VittorioCoseglia/JBR/gabinete/Gabinete.SLDASM

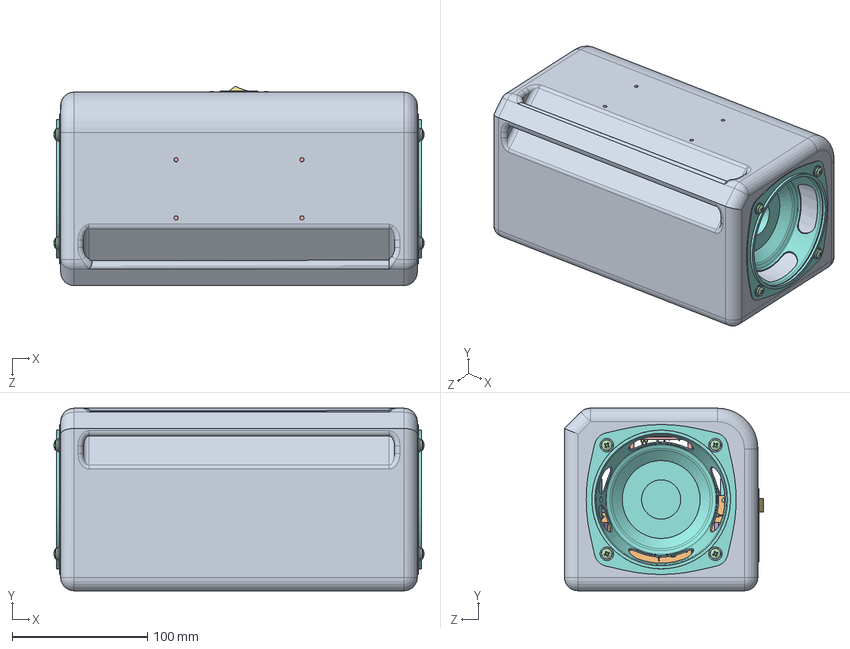
[picture p19: CAD file, 2026-11-05]
gabinete/Gabinete.SLDASM
273.4 x 135.0 x 147.2 mm
Pieza1
Trafo9V.stp
CP_Radial_D22.0mm_P10.00mm_SnapIn.step x 4
TerminalBlock_Phoenix_MKDS-1,5-3_1x03_P5.00mm_Horizontal.step x 6
Diode_Bridge_Vishay_GBU.step
Fuente x4_PCB.step
HeatSink.step x 4
M2x6-Screw.step x 4
R_Axial_DIN0207_L6.3mm_D2.5mm_P10.16mm_Horizontal.step x 18
R_Axial_DIN0309_L9.0mm_D3.2mm_P15.24mm_Horizontal.step x 2
C_Radial_D6.3mm_H11.0mm_P2.50mm.step x 2
Potentiometer_Bourns_3296W_Vertical.step x 4
D_DO-35_SOD27_P7.62mm_Horizontal.step x 12
TerminalBlock_Phoenix_MKDS-1,5-2_1x02_P5.00mm_Horizontal.step x 4
TO-126-3_Vertical.step x 4
wakefield-vette heatsink 281-3AB.step x 4
C_Disc_D5.0mm_W2.5mm_P2.50mm.step x 8
R_Axial_Power_L25.0mm_W6.4mm_P30.48mm.step x 4
D_DO-41_SOD81_P10.16mm_Horizontal.step x 4
TO-220-3_Vertical.step x 4
DIP-8_W7.62mm.step x 2
DIP-8_W7.62mm_Socket.step x 2
TO-92_Inline.step x 2
C_Radial_D10.0mm_H20.0mm_P5.00mm.step x 4
C_Disc_D3.0mm_W2.0mm_P2.50mm.step x 2
AB_PCB.step x 2
fuse_holder
fuse
Plate x 3
Button
Speaker 30W 4-Ohm 4-inch.step x 2
plain washer 10669 type nl_iso x 22
countersunk raised head cross recess screw_iso x 2
hex thin nut chamfered gradeab_iso x 40
pan head cross recess screw_iso x 14
Varilla x 4
PinHeader_1x01_P2.00mm_Horizontal.step.STEP x 3
PinHeader_1x01_P2.00mm_Vertical.step.STEP x 2
TO-220-3_Horizontal_TabDown.step.STEP
LED_D5.0mm.step.STEP
C_Radial_D5.0mm_H11.0mm_P2.00mm.step.STEP x 2
R_Axial_DIN0207_L6.3mm_D2.5mm_P10.16mm_Horizontal.step.STEP
TerminalBlock_Phoenix_MKDS-1,5-2_1x02_P5.00mm_Horizontal.step.STEP x 3
Control_PCB.step.STEP
001^PJ311D_WOPos.step.STEP
002^PJ311D_WOPos.step.STEP
003^PJ311D_WOPos.step.STEP
004^PJ311D_WOPos.step.STEP
005^PJ311D_WOPos.step.STEP
006^PJ311D_WOPos.step.STEP
007^PJ311D_WOPos.step.STEP
Crystal 24MHz v1.step.STEP
SMD_CAP.step.STEP x 7
RESISTOR_SMD.step.STEP x 3
CAPAE-D6.3x5.4.step.STEP x 2
SW3dPS-SOIC24 v1.step.STEP
RESISTOR_SMD v2.step.STEP
REAL-Usb 5pin Board.step.STEP
LITE-ON - LTST-C190KFKT.step.STEP
BT Board VHM-314.step-0.STEP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
