VittorioCoseglia/JBR/gabinete/Accesorios/CRH.SLDASM

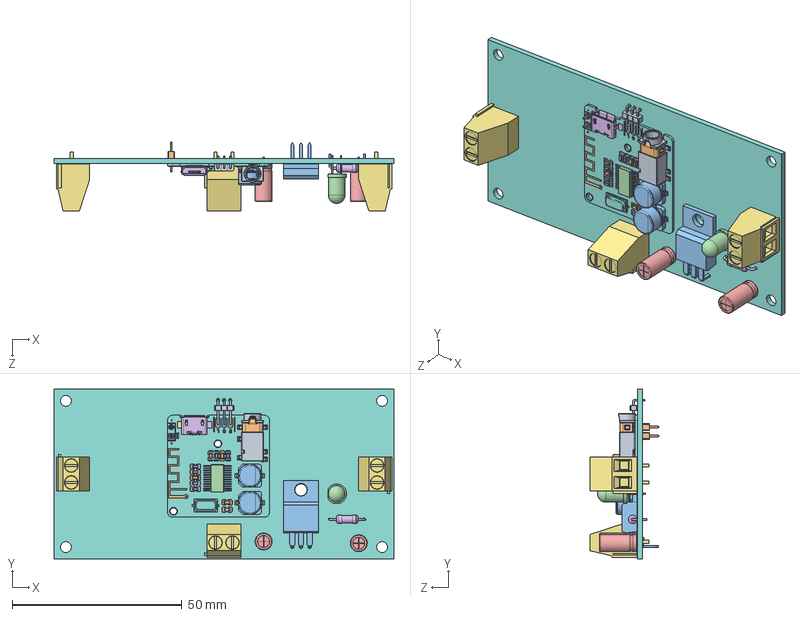
[picture p20: CAD file, 2026-11-05]
gabinete/Accesorios/CRH.SLDASM
100.0 x 50.0 x 20.2 mm
PinHeader_1x01_P2.00mm_Horizontal.step x 3
PinHeader_1x01_P2.00mm_Vertical.step x 2
TO-220-3_Horizontal_TabDown.step
LED_D5.0mm.step
C_Radial_D5.0mm_H11.0mm_P2.00mm.step x 2
R_Axial_DIN0207_L6.3mm_D2.5mm_P10.16mm_Horizontal.step
TerminalBlock_Phoenix_MKDS-1,5-2_1x02_P5.00mm_Horizontal.step x 3
Control_PCB.step
001^PJ311D_WOPos.step
002^PJ311D_WOPos.step
003^PJ311D_WOPos.step
004^PJ311D_WOPos.step
005^PJ311D_WOPos.step
006^PJ311D_WOPos.step
007^PJ311D_WOPos.step
Crystal 24MHz v1.step
SMD_CAP.step x 7
RESISTOR_SMD.step x 3
CAPAE-D6.3x5.4.step x 2
SW3dPS-SOIC24 v1.step
RESISTOR_SMD v2.step
REAL-Usb 5pin Board.step
LITE-ON - LTST-C190KFKT.step
BT Board VHM-314.step
BT Board VHM-314-0.step
BT Board VHM-314-1.step
BT Board VHM-314-2.step
BT Board VHM-314-3.step
BT Board VHM-314-4.step
BT Board VHM-314-5.step
BT Board VHM-314-6.step
BT Board VHM-314-7.step
BT Board VHM-314-8.step
BT Board VHM-314-9.step
BT Board VHM-314-10.step
BT Board VHM-314-11.step
BT Board VHM-314-12.step
BT Board VHM-314-13.step
BT Board VHM-314-14.step
BT Board VHM-314-15.step
BT Board VHM-314-16.step
BT Board VHM-314-17.step
BT Board VHM-314-18.step
BT Board VHM-314-19.step
BT Board VHM-314-20.step
BT Board VHM-314-21.step
BT Board VHM-314-22.step
BT Board VHM-314-23.step
BT Board VHM-314-24.step
BT Board VHM-314-25.step
BT Board VHM-314-26.step
BT Board VHM-314-27.step
BT Board VHM-314-28.step
BT Board VHM-314-29.step
BT Board VHM-314-30.step
BT Board VHM-314-31.step
BT Board VHM-314-32.step
BT Board VHM-314-33.step
BT Board VHM-314-34.step
BT Board VHM-314-35.step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
