VittorioCoseglia/JBR/gabinete/Impresion 3D/Solidworks/conjunto.SLDASM

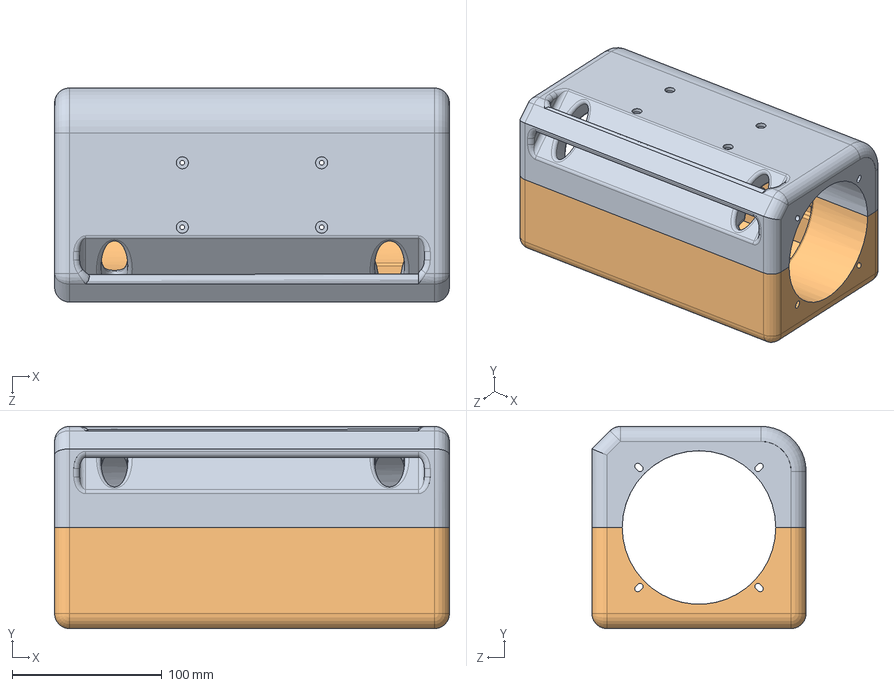
[picture p21: CAD file, 2026-11-05]
gabinete/Impresion 3D/Solidworks/conjunto.SLDASM
263.7 x 135.0 x 143.0 mm
abajo
arriba
