VittorioCoseglia/JBR/gabinete/Accesorios/AC_01A_Assem/AC_01A_Assem.SLDASM

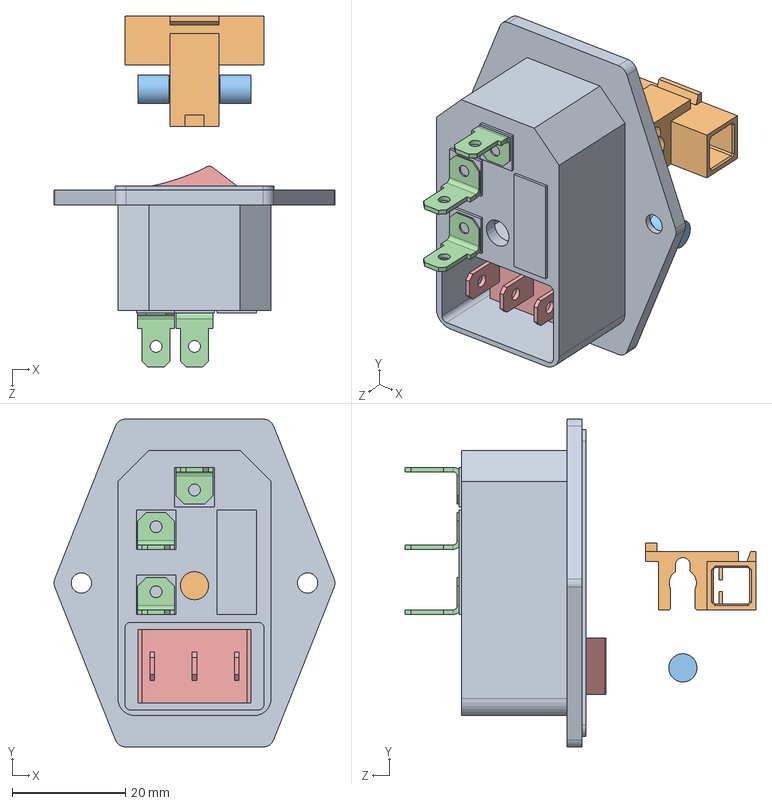
[picture p22: CAD file, 2026-11-05]
gabinete/Accesorios/AC_01A_Assem/AC_01A_Assem.SLDASM
49.7 x 58.0 x 62.0 mm
fuse_holder
fuse
Plate x 3
Button
