VittorioCoseglia/JBR/AB/3D/HeatsinkTO220.step

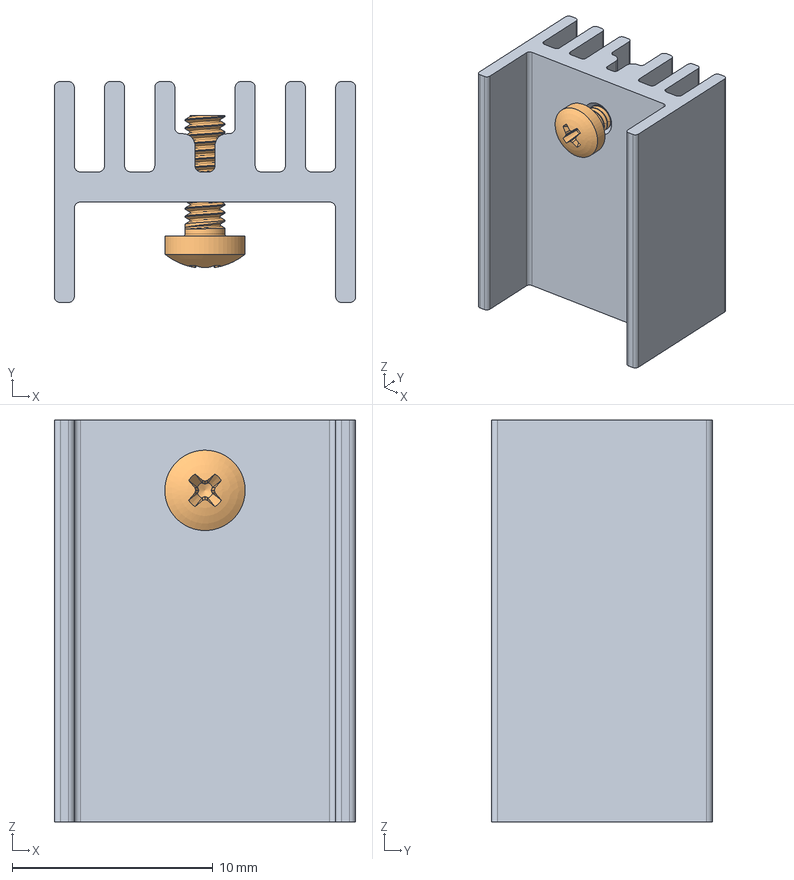
[picture p23: CAD file, 2026-11-05]
AB/3D/HeatsinkTO220.step
15.0 x 11.0 x 20.0 mm
HeatSink
M2x6-Screw
