VittorioCoseglia/JBR/gabinete/Accesorios/AC_01A_Assem/Plate.SLDPRT

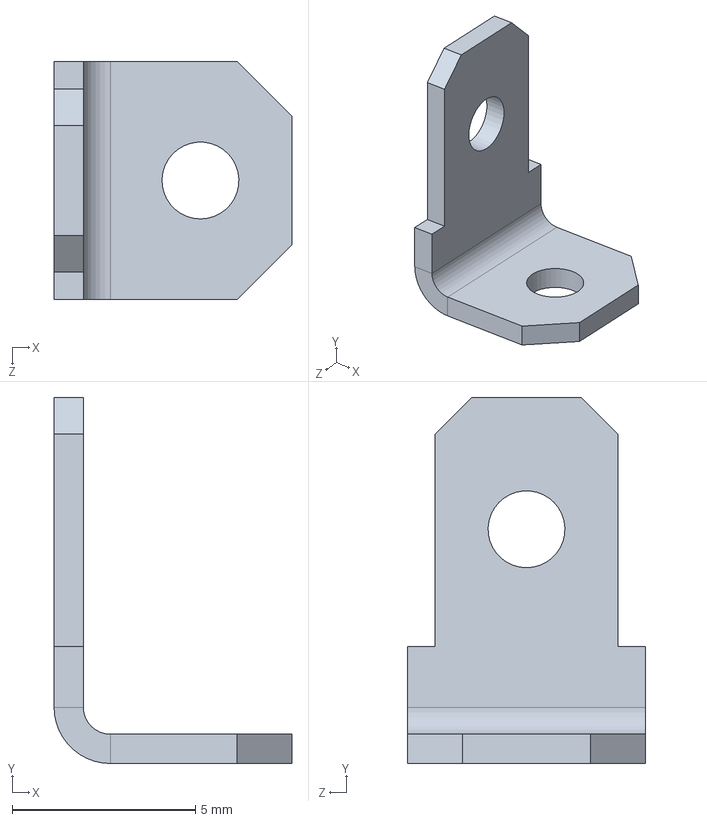
[picture p24: CAD file, 2026-11-05]
gabinete/Accesorios/AC_01A_Assem/Plate.SLDPRT
6.50 x 10.0 x 6.50 mm
