VittorioCoseglia/JBR/gabinete/Accesorios/Trafo9V.stp

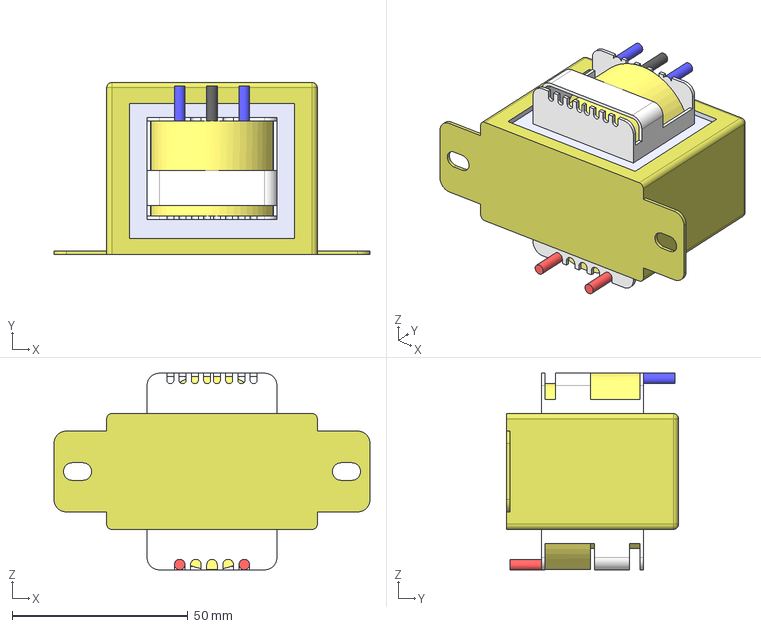
[picture p25: CAD file, 2026-11-05]
gabinete/Accesorios/Trafo9V.stp
90.0 x 49.0 x 56.0 mm
