VittorioCoseglia/JBR/gabinete/Impresion 3D/Solidworks/abajo.SLDPRT

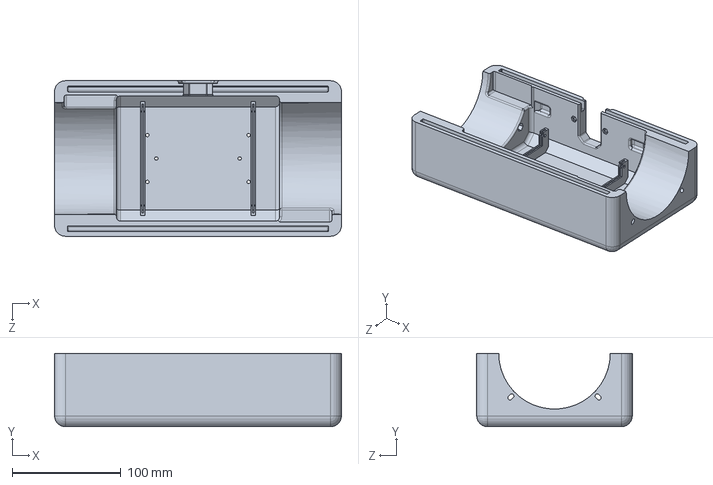
[picture p26: CAD file, 2026-11-05]
gabinete/Impresion 3D/Solidworks/abajo.SLDPRT
263.7 x 67.5 x 143.0 mm
