VittorioCoseglia/JBR/gabinete/PCBs/CTR/CRH.step

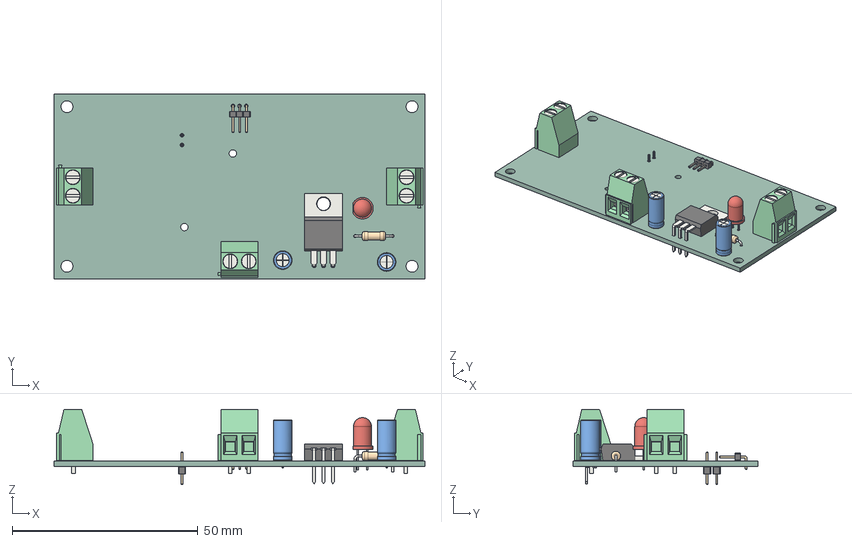
[picture p27: CAD file, 2026-11-05]
gabinete/PCBs/CTR/CRH.step
100.0 x 50.0 x 20.2 mm
PinHeader_1x01_P2.00mm_Horizontal x 3
PinHeader_1x01_P2.00mm_Vertical x 2
TO-220-3_Horizontal_TabDown
LED_D5.0mm
C_Radial_D5.0mm_H11.0mm_P2.00mm x 2
R_Axial_DIN0207_L6.3mm_D2.5mm_P10.16mm_Horizontal
TerminalBlock_Phoenix_MKDS-1,5-2_1x02_P5.00mm_Horizontal x 3
Control_PCB
