VittorioCoseglia/JBR/AB/3D/wakefield-vette heatsink 281-3AB.stp

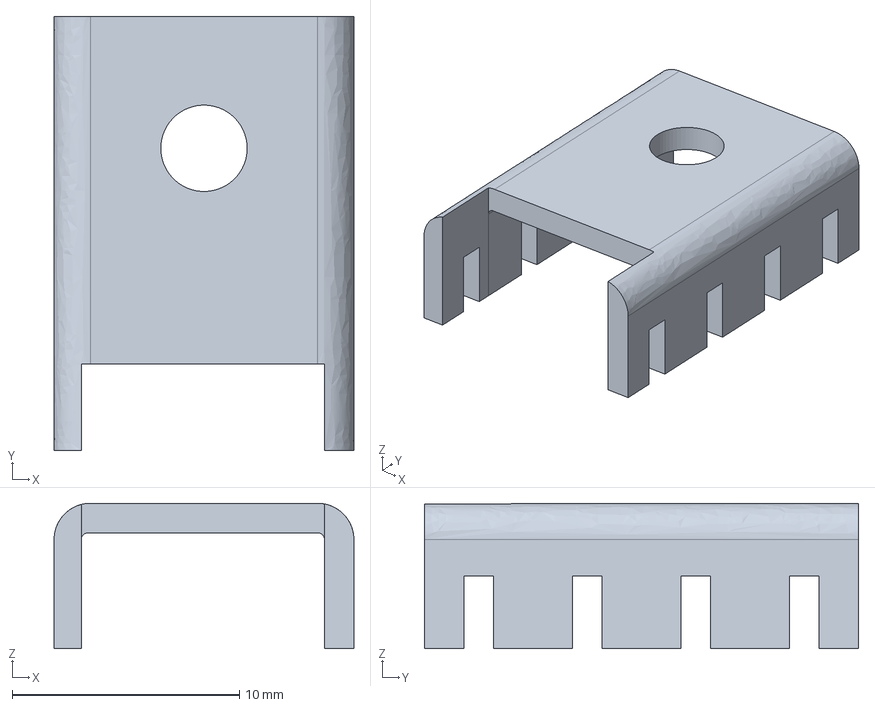
[picture p28: CAD file, 2026-11-05]
AB/3D/wakefield-vette heatsink 281-3AB.stp
13.2 x 19.1 x 6.40 mm
