VittorioCoseglia/JBR/gabinete/Accesorios/AC_01A_Assem/fuse.SLDPRT

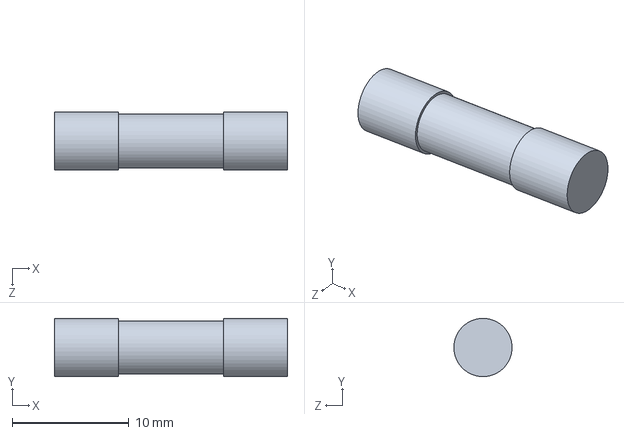
[picture p29: CAD file, 2026-11-05]
gabinete/Accesorios/AC_01A_Assem/fuse.SLDPRT
20.0 x 5.00 x 5.00 mm
