VittorioCoseglia/JBR/gabinete/Accesorios/Speaker 30W 4-Ohm 4-inch.step

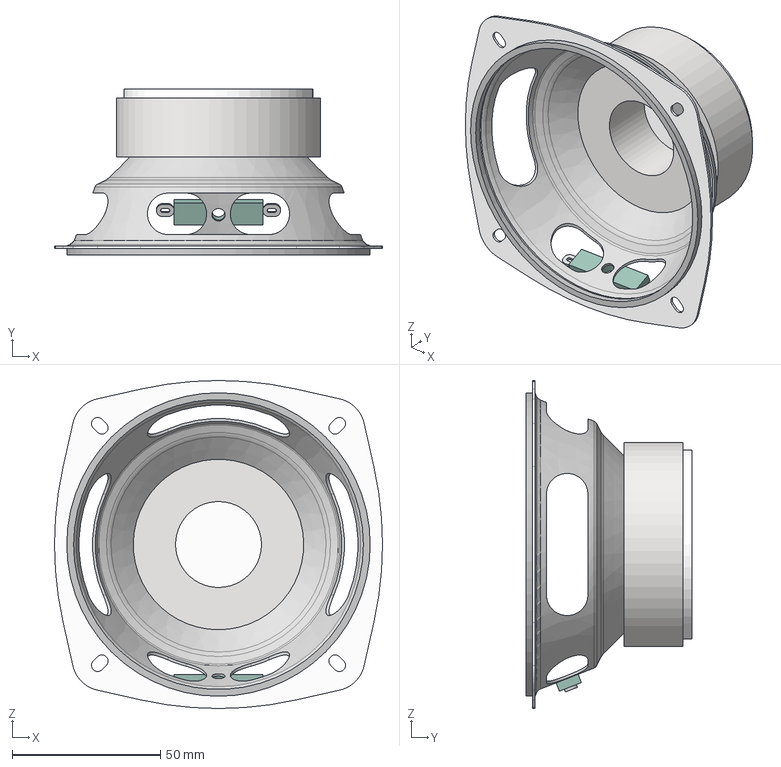
[picture p30: CAD file, 2026-11-05]
gabinete/Accesorios/Speaker 30W 4-Ohm 4-inch.step
110.8 x 56.2 x 110.8 mm
