VittorioCoseglia/JBR/gabinete/Impresion 3D/Solidworks/arriba.SLDPRT

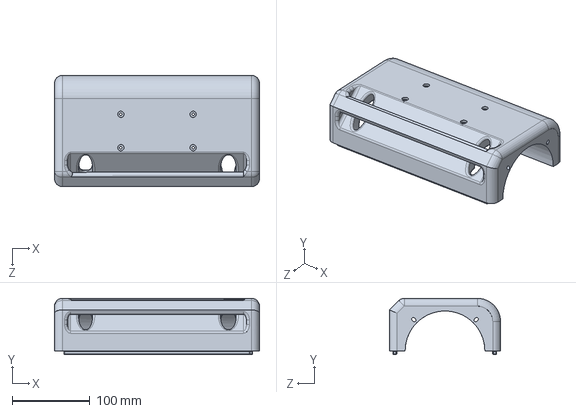
[picture p31: CAD file, 2026-11-05]
gabinete/Impresion 3D/Solidworks/arriba.SLDPRT
263.7 x 72.5 x 143.0 mm
