VittorioCoseglia/JBR/gabinete/PCBs/AB.step

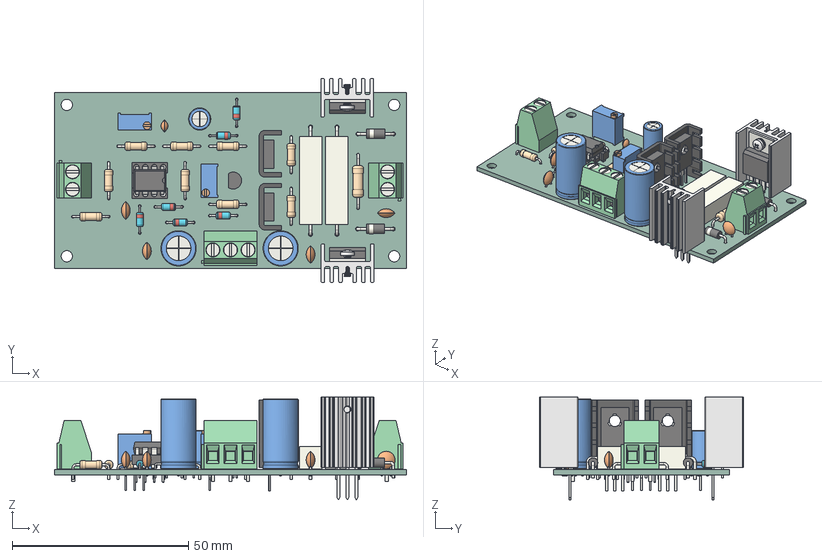
[picture p32: CAD file, 2026-11-05]
gabinete/PCBs/AB.step
100.0 x 57.9 x 29.2 mm
R_Axial_DIN0207_L6.3mm_D2.5mm_P10.16mm_Horizontal x 9
R_Axial_DIN0309_L9.0mm_D3.2mm_P15.24mm_Horizontal
C_Radial_D6.3mm_H11.0mm_P2.50mm
Potentiometer_Bourns_3296W_Vertical x 2
D_DO-35_SOD27_P7.62mm_Horizontal x 6
TerminalBlock_Phoenix_MKDS-1,5-2_1x02_P5.00mm_Horizontal x 2
TO-126-3_Vertical x 2
wakefield-vette heatsink 281-3AB x 2
C_Disc_D5.0mm_W2.5mm_P2.50mm x 4
R_Axial_Power_L25.0mm_W6.4mm_P30.48mm x 2
D_DO-41_SOD81_P10.16mm_Horizontal x 2
TO-220-3_Vertical x 2
HeatSink x 2
M2x6-Screw x 2
DIP-8_W7.62mm
DIP-8_W7.62mm_Socket
TO-92_Inline
C_Radial_D10.0mm_H20.0mm_P5.00mm x 2
TerminalBlock_Phoenix_MKDS-1,5-3_1x03_P5.00mm_Horizontal
C_Disc_D3.0mm_W2.0mm_P2.50mm
AB_PCB
