VittorioCoseglia/JBR/gabinete/Accesorios/AC_01A_Assem/Button.SLDPRT

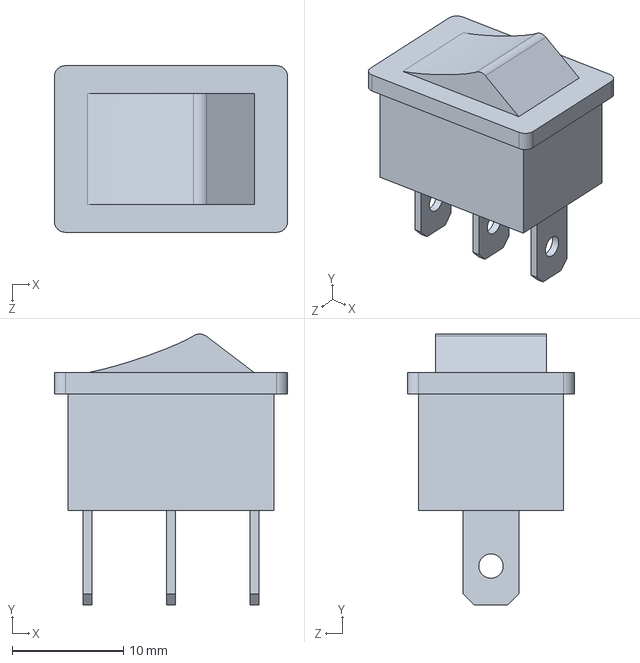
[picture p33: CAD file, 2026-11-05]
gabinete/Accesorios/AC_01A_Assem/Button.SLDPRT
21.0 x 24.4 x 15.0 mm
