VittorioCoseglia/JBR/gabinete/PCBs/Fuente.step

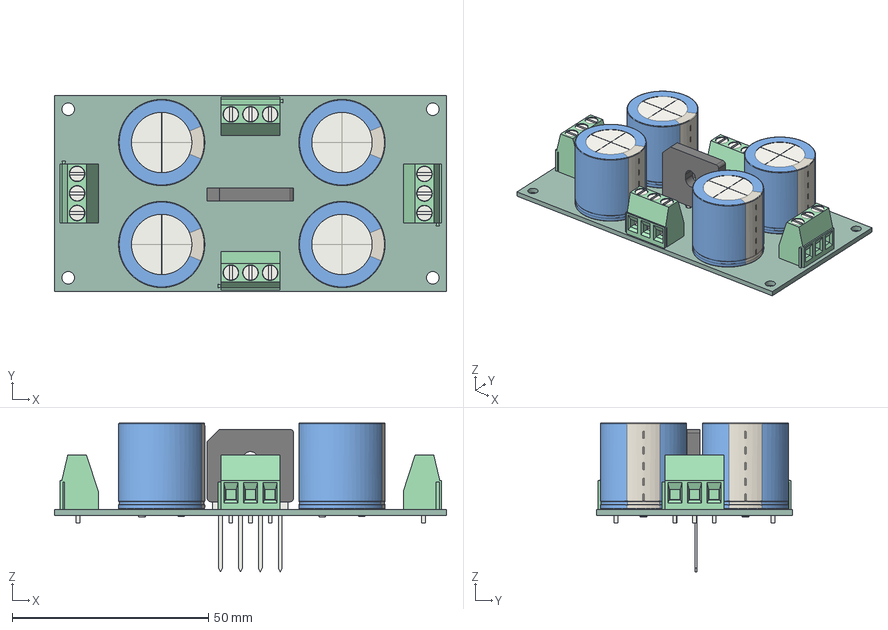
[picture p34: CAD file, 2026-11-05]
gabinete/PCBs/Fuente.step
100.0 x 50.0 x 38.0 mm
CP_Radial_D22.0mm_P10.00mm_SnapIn x 4
TerminalBlock_Phoenix_MKDS-1,5-3_1x03_P5.00mm_Horizontal x 4
Diode_Bridge_Vishay_GBU
Fuente x4_PCB
