VittorioCoseglia/JBR/gabinete/Pieza1.SLDPRT

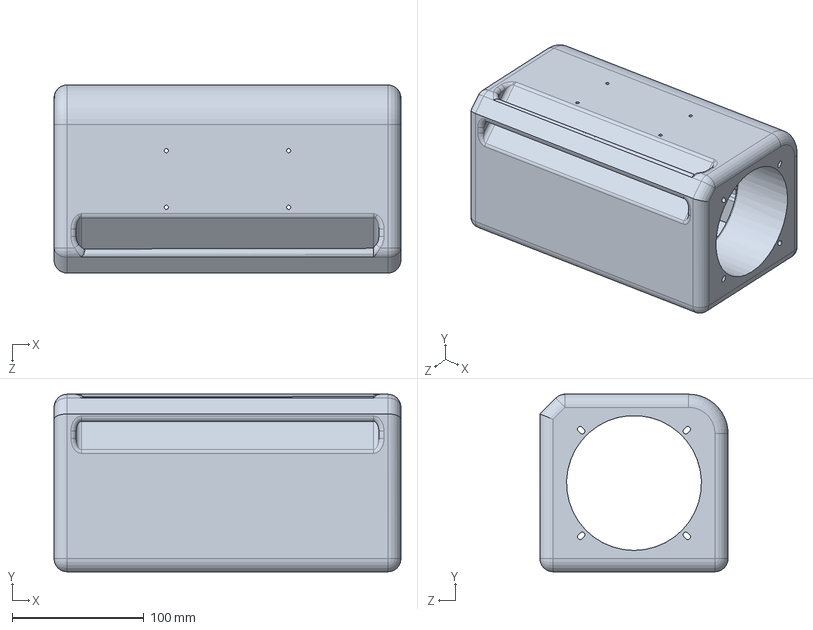
[picture p35: CAD file, 2026-11-05]
gabinete/Pieza1.SLDPRT
263.7 x 135.0 x 143.0 mm
