VittorioCoseglia/JBR/gabinete/Accesorios/AC_01A_Assem/fuse_holder.SLDPRT

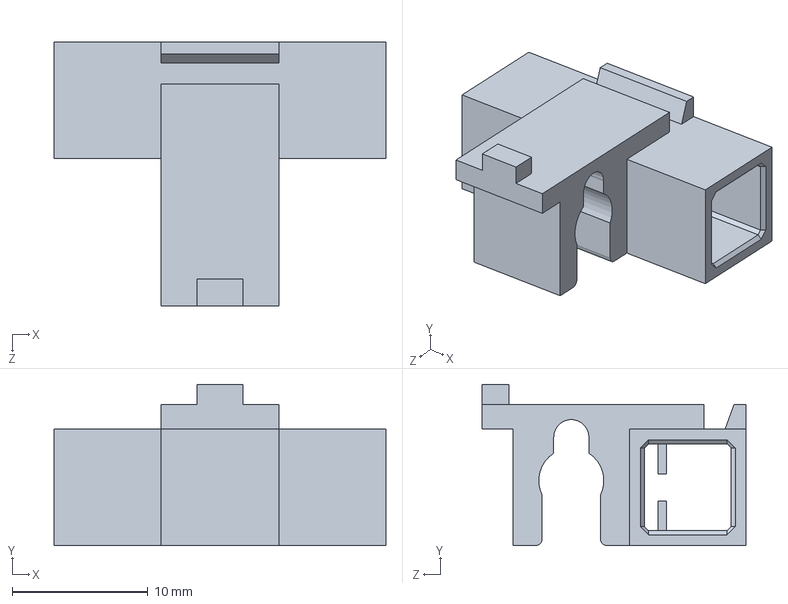
[picture p36: CAD file, 2026-11-05]
gabinete/Accesorios/AC_01A_Assem/fuse_holder.SLDPRT
24.5 x 11.9 x 19.5 mm
