VittorioCoseglia/JBR/gabinete/Accesorios/BT Board VHM-314.step

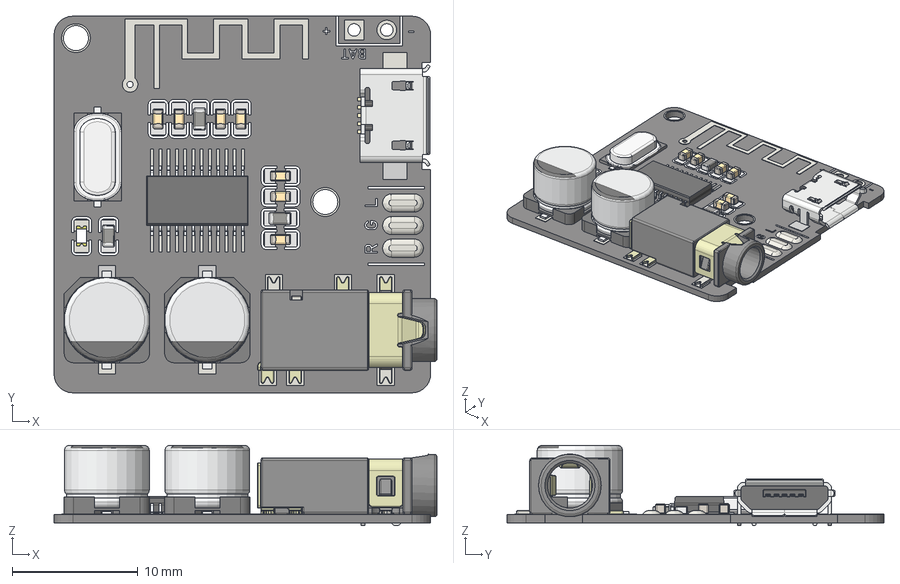
[picture p37: CAD file, 2026-11-05]
gabinete/Accesorios/BT Board VHM-314.step
30.5 x 30.0 x 6.40 mm
001^PJ311D_WOPos
002^PJ311D_WOPos
003^PJ311D_WOPos
004^PJ311D_WOPos
005^PJ311D_WOPos
006^PJ311D_WOPos
007^PJ311D_WOPos
Crystal 24MHz v1
SMD_CAP x 7
RESISTOR_SMD x 3
CAPAE-D6.3x5.4 x 2
SW3dPS-SOIC24 v1
RESISTOR_SMD v2
REAL-Usb 5pin Board
LITE-ON - LTST-C190KFKT
