VittorioCoseglia/JBR/gabinete/Accesorios/AC_01A_Assem/Body.SLDPRT

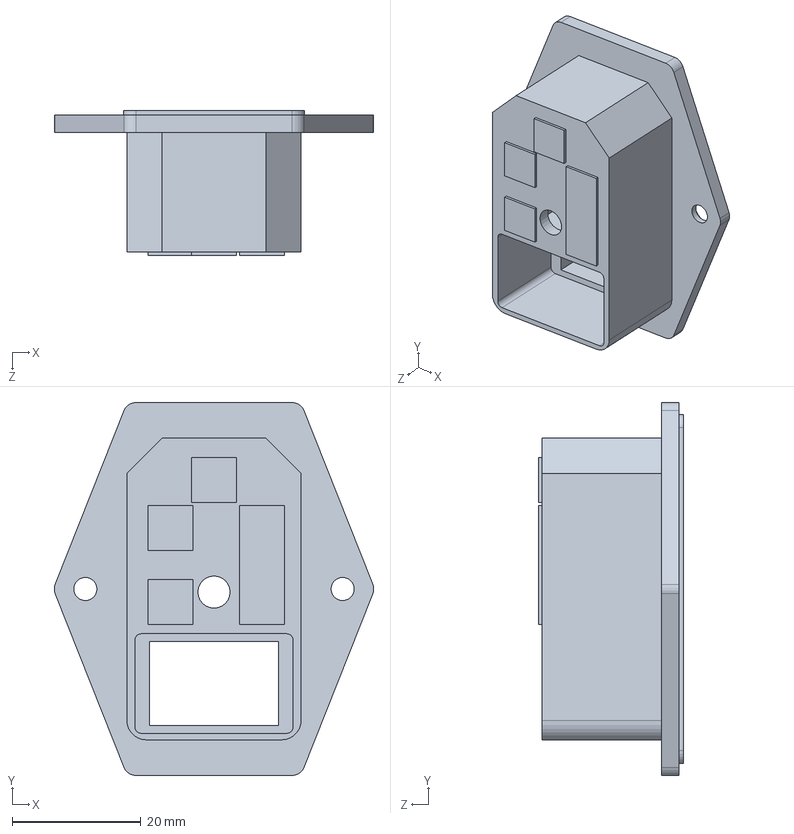
[picture p38: CAD file, 2026-11-05]
gabinete/Accesorios/AC_01A_Assem/Body.SLDPRT
49.7 x 58.0 x 22.5 mm
