VittorioCoseglia/JBR/(list of files, cad)

Other CAD files:
gabinete/PCBs/HeatsinkTO220.step.SLDASM
gabinete/Varilla.SLDPRT
gabinete/PCBs/HeatSink.step.SLDPRT
gabinete/PCBs/AB_PCB.step.SLDPRT
gabinete/PCBs/CRH.STEP
gabinete/PCBs/wakefield-vette heatsink 281-3AB.step.SLDPRT
gabinete/Impresion 3D/stl/abajo.STL
gabinete/Impresion 3D/stl/arriba.STL
gabinete/PCBs/CTR/CRH.SLDASM
gabinete/PCBs/M2x6-Screw.step.SLDPRT
