VittorioCoseglia/JBR/docs/PDF/Schem/FuenteSchem.pdf

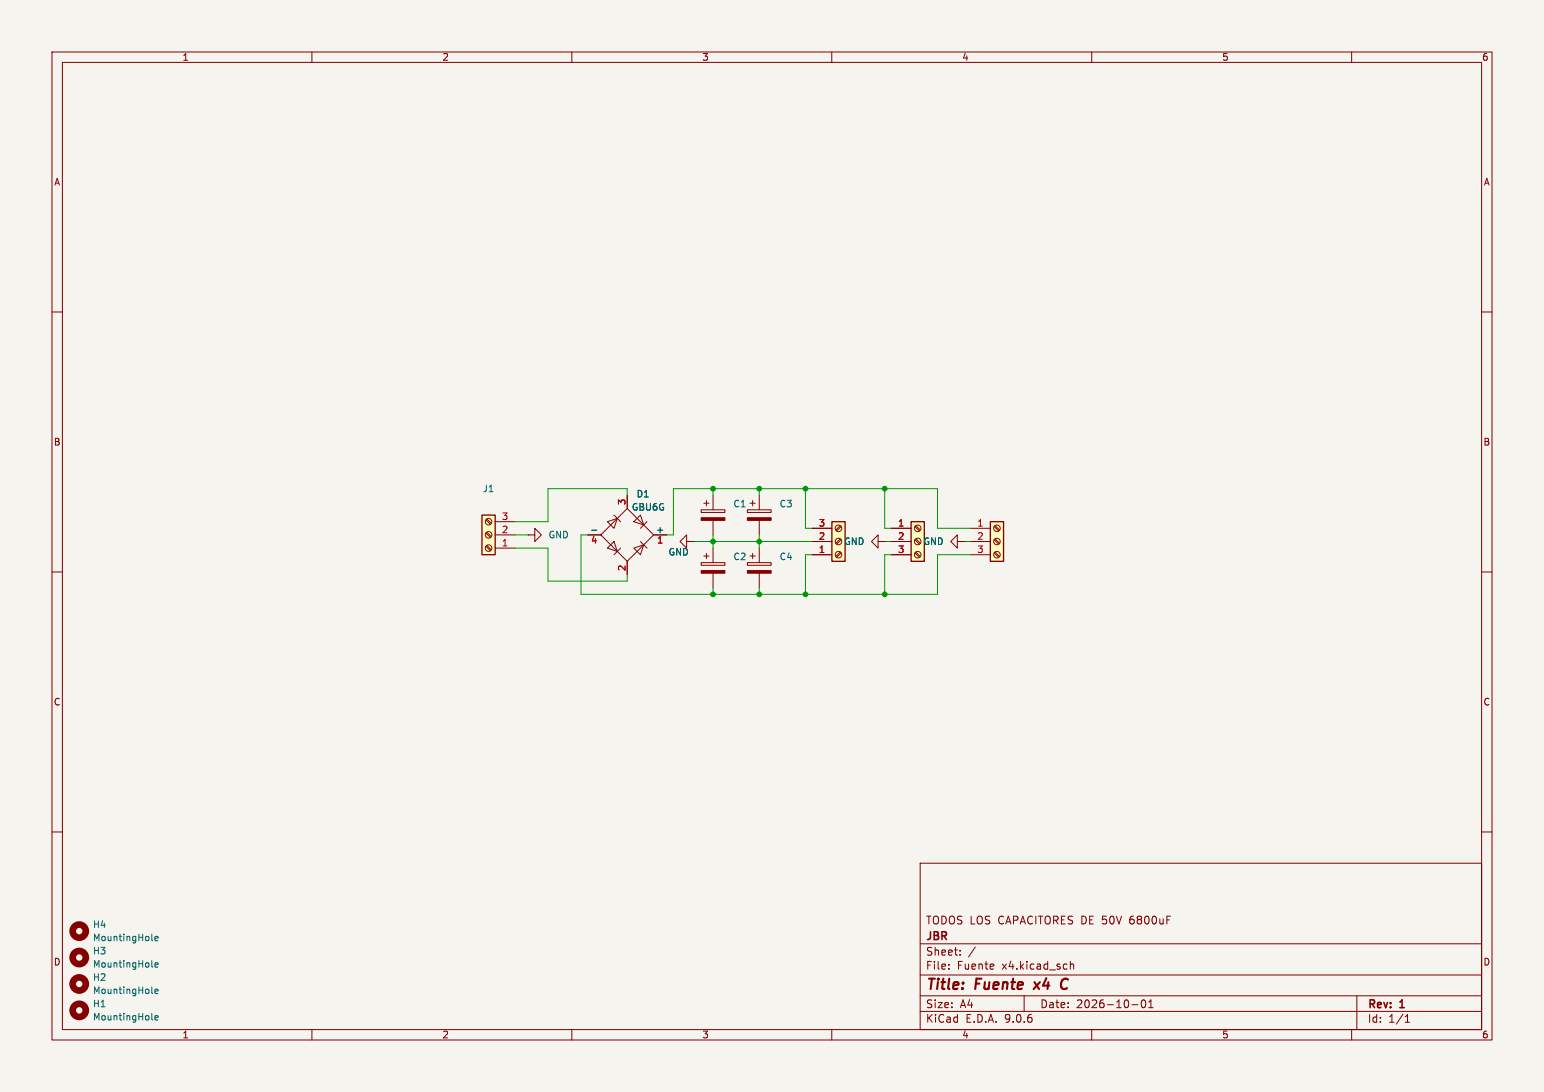
[picture p39: page 1]

File: Fuente x4.kicad_sch Sheet: / JBR
