VittorioCoseglia/JBR/docs/PDF/Schem/ABSchem.pdf

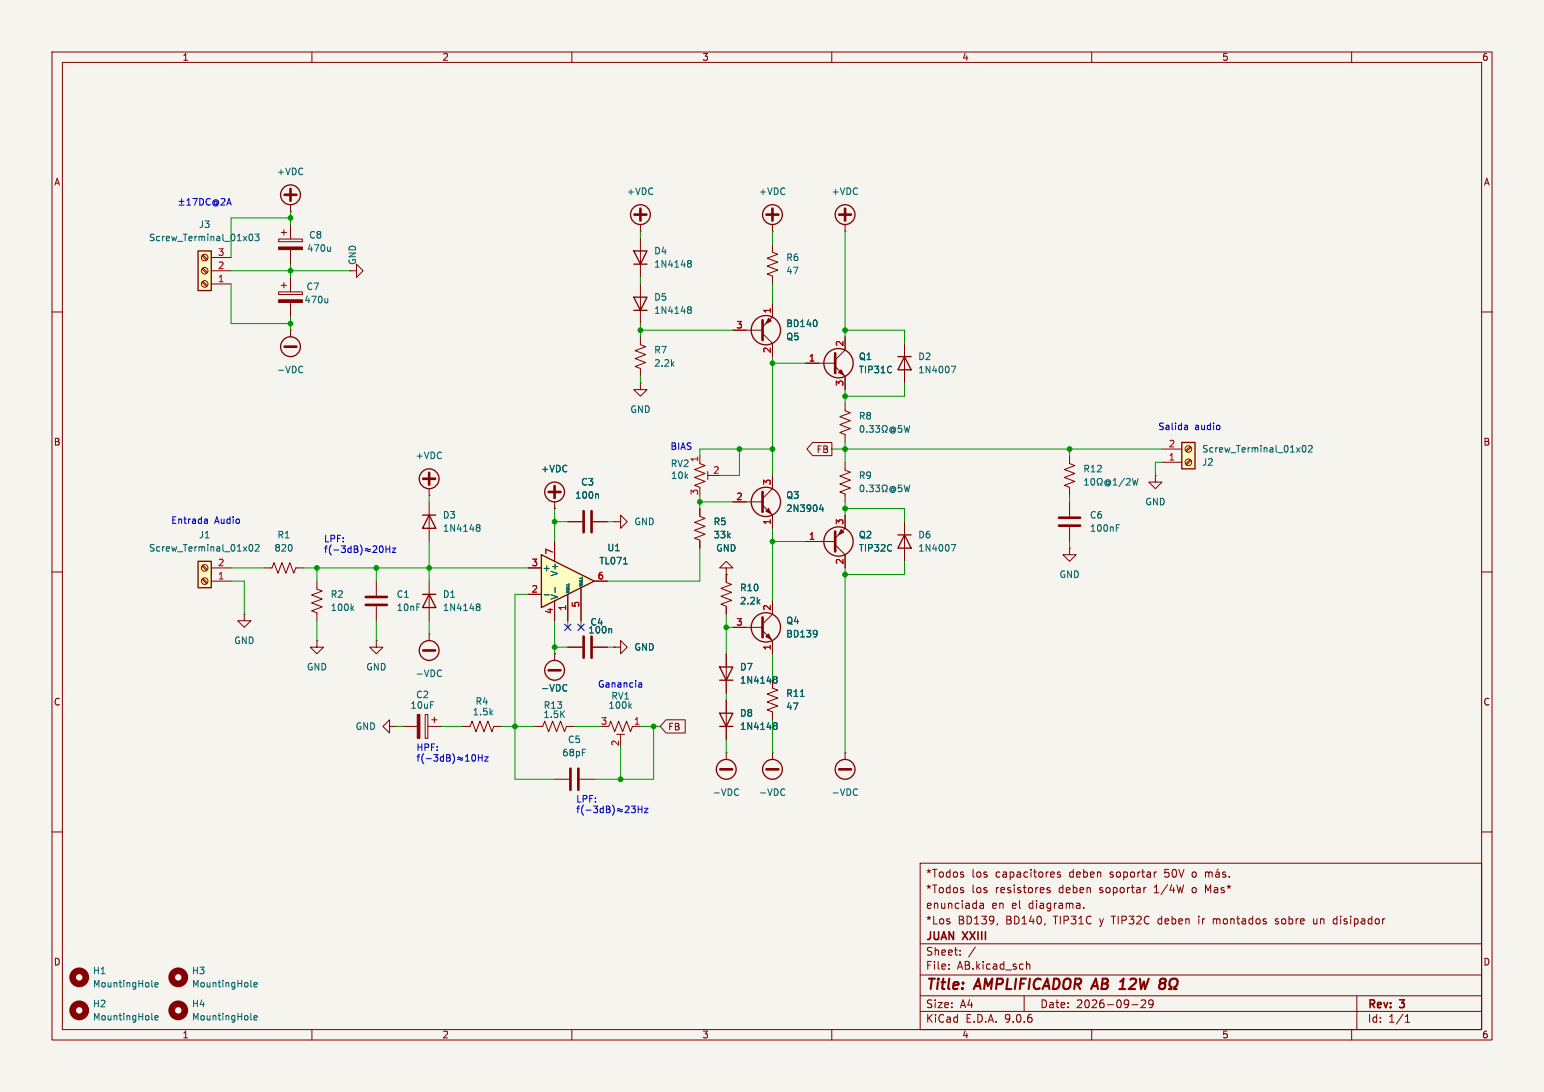
[picture p40: page 1]

Id: 1/1 Title: AMPLIFICADOR AB 12W þÿ8©
