VittorioCoseglia/JBR/docs/PDF/Schem/ControlSchem.pdf

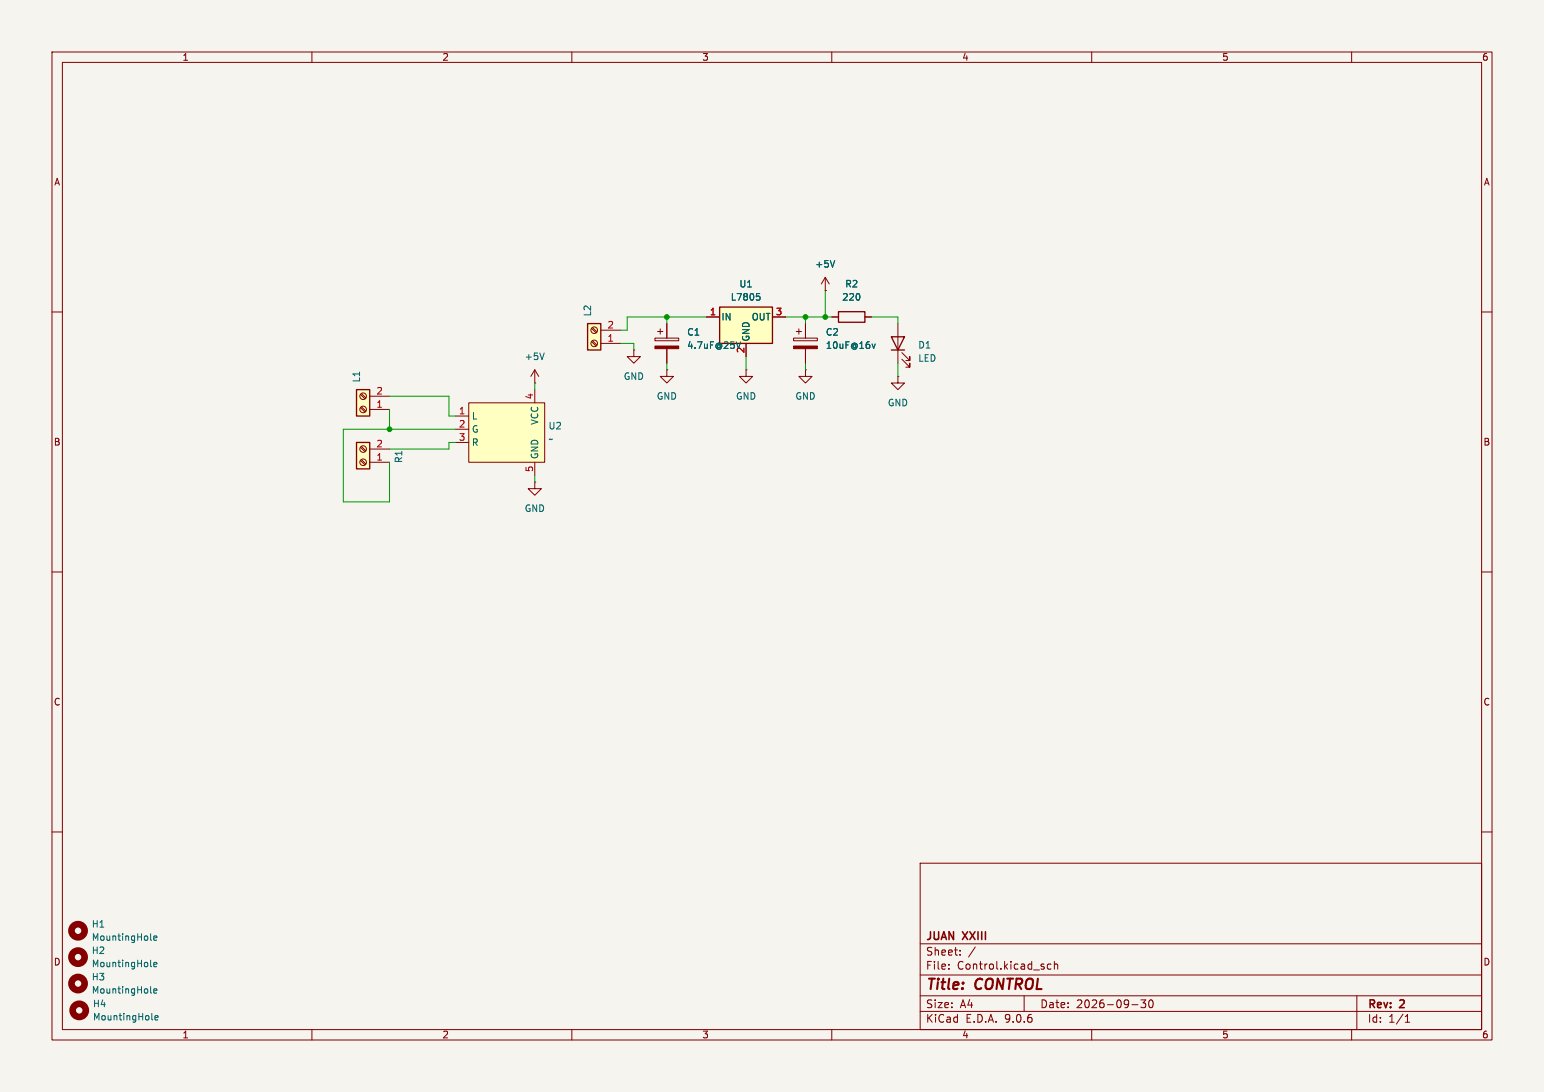
[picture p41: page 1]
