VittorioCoseglia/JBR/docs/PDF/Transferencia/AB/ABBc.pdf

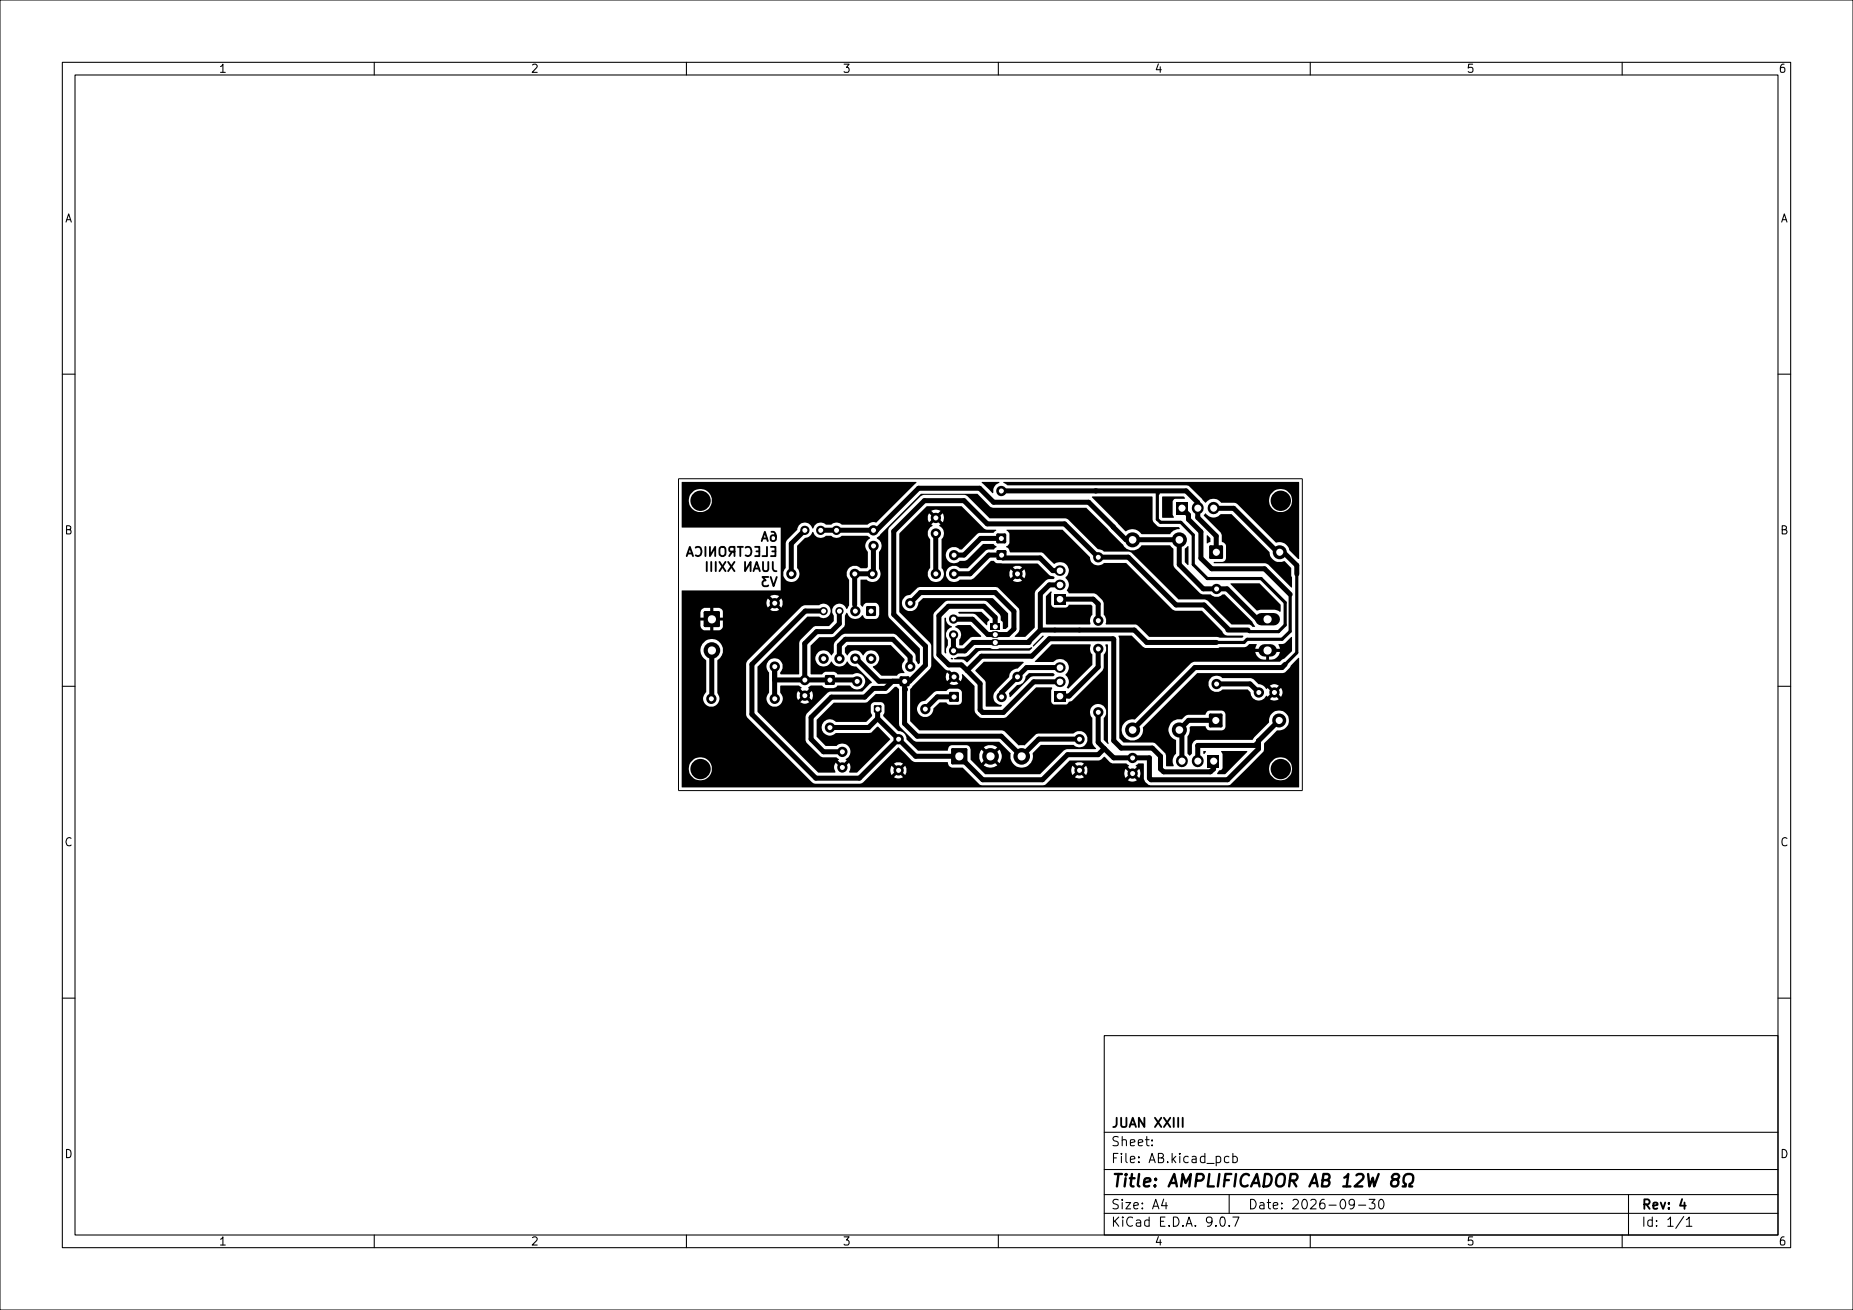
[picture p42: page 1]
