VittorioCoseglia/JBR/docs/PDF/Transferencia/AB/ABSilk.pdf

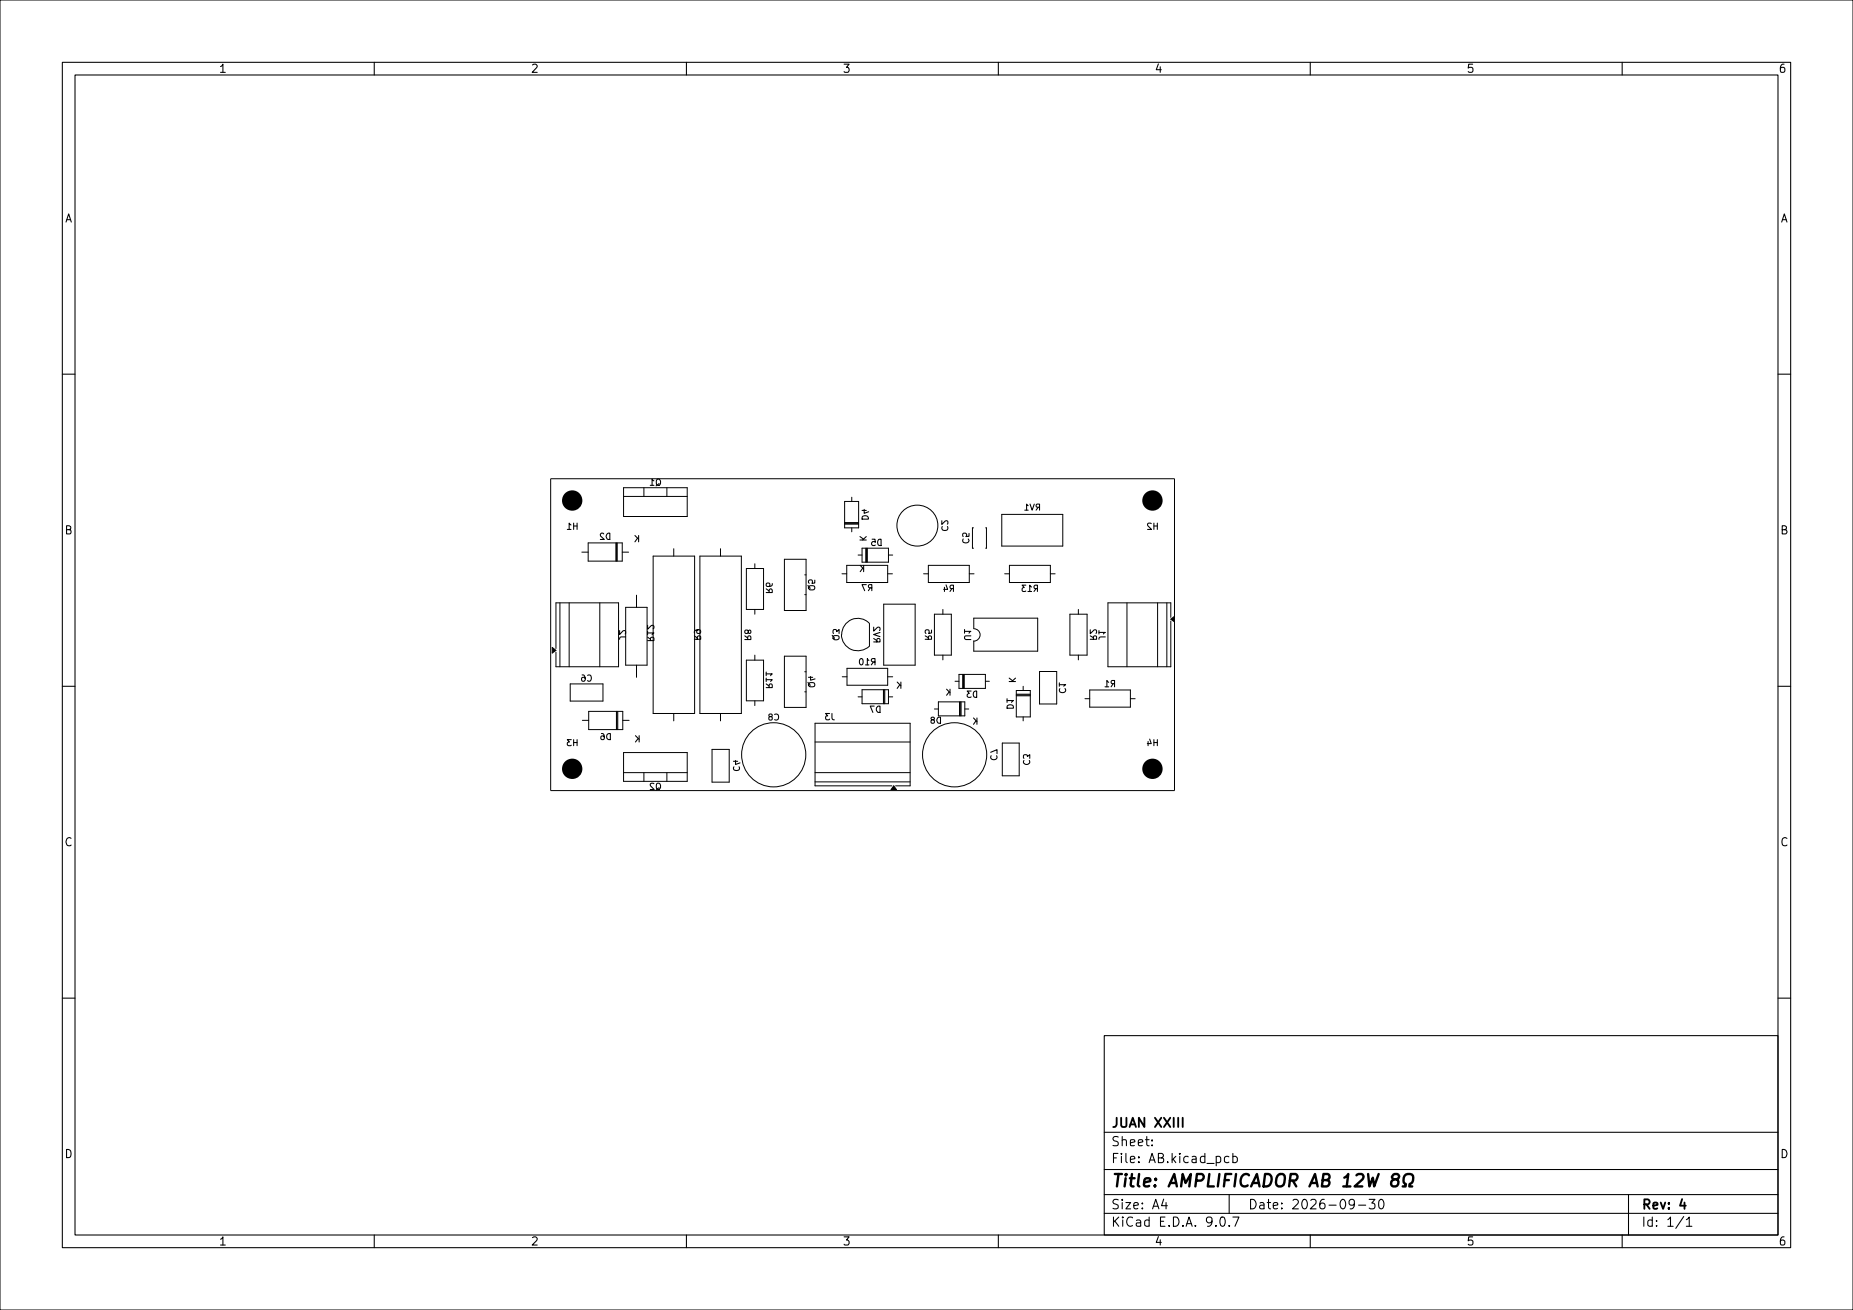
[picture p43: page 1]
