VittorioCoseglia/JBR/docs/PDF/Transferencia/Control/ControlBc.pdf

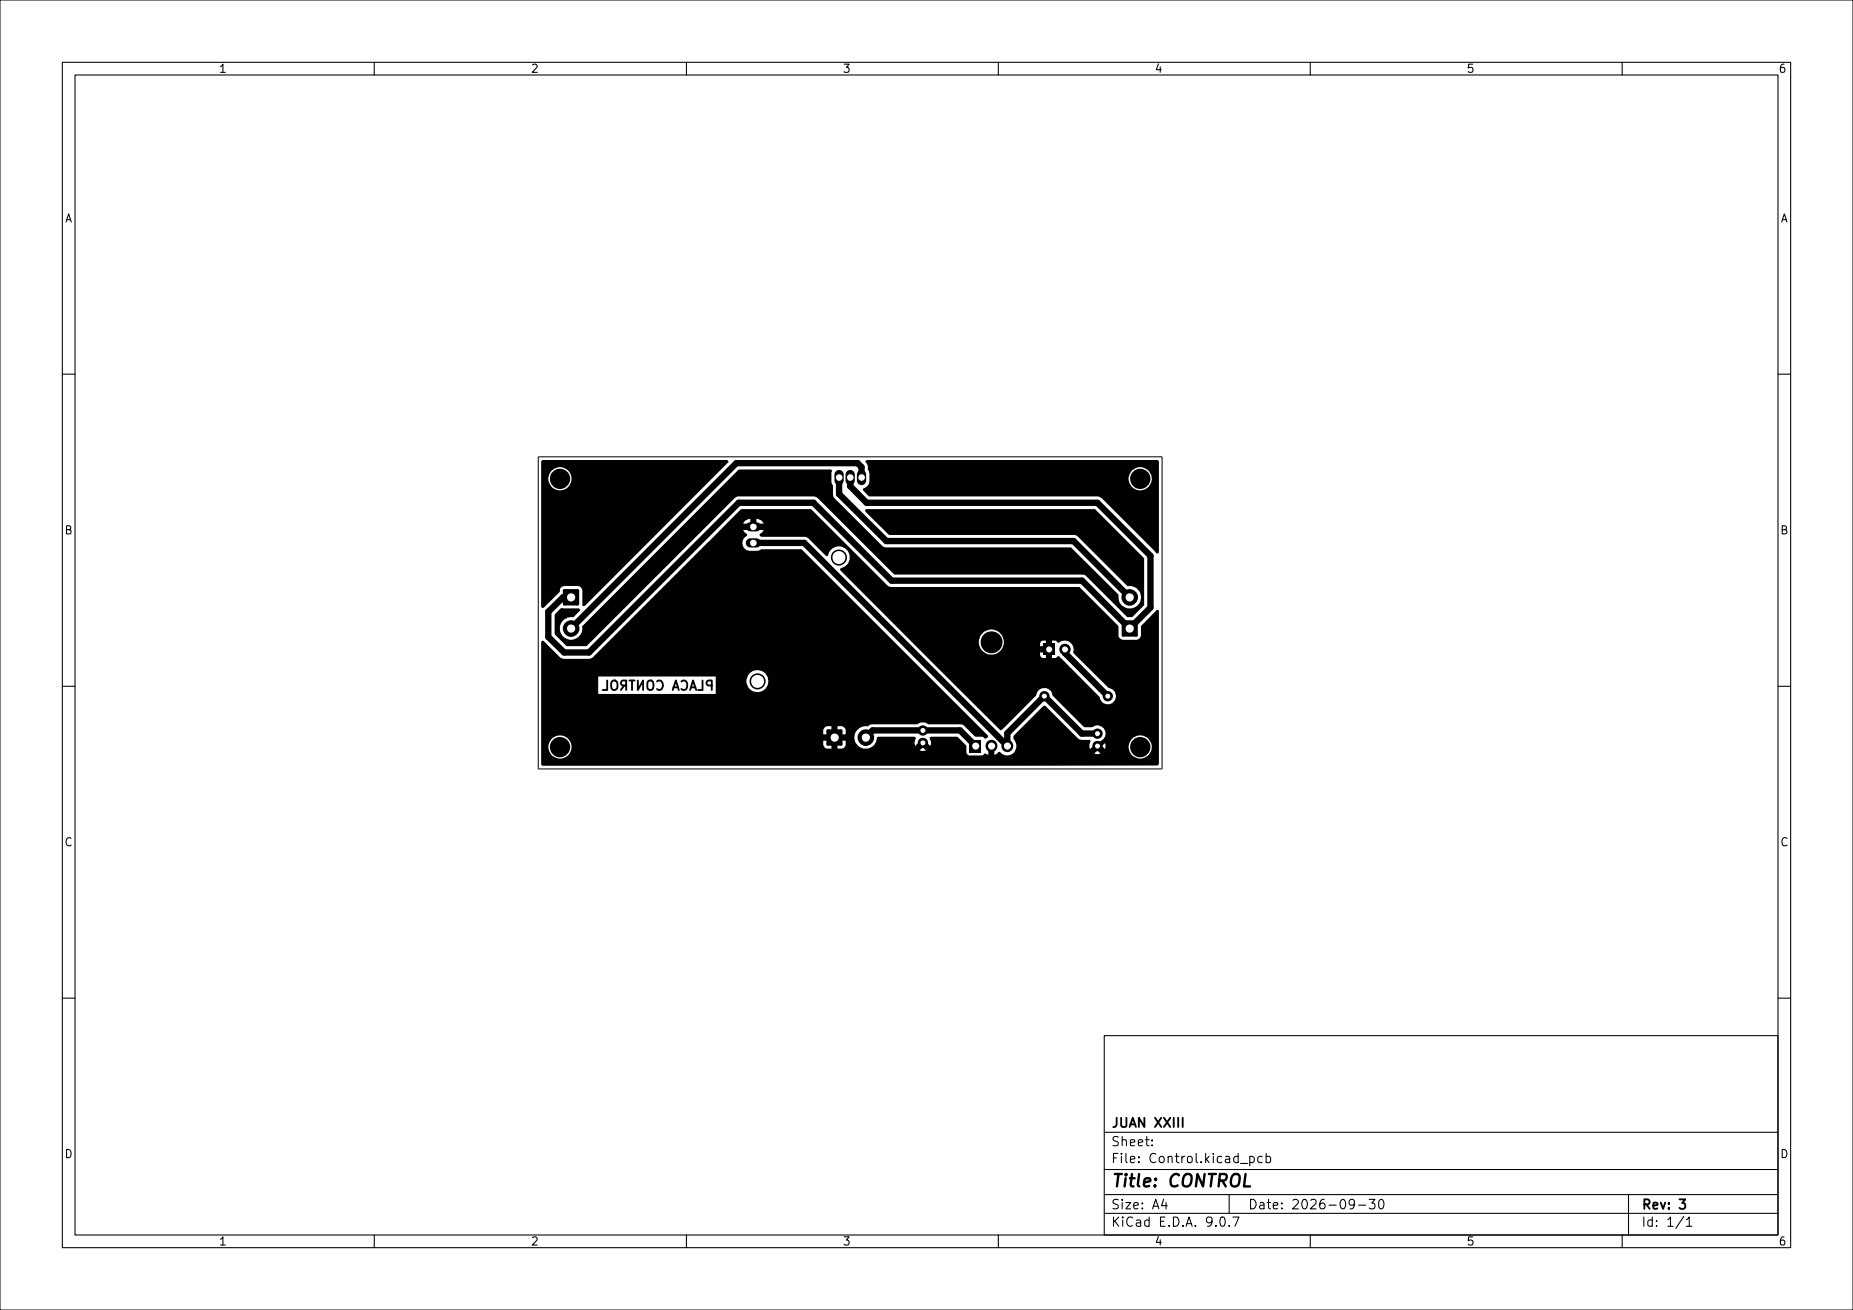
[picture p44: page 1]
