VittorioCoseglia/JBR/docs/PDF/Transferencia/Control/ControlSilk.pdf

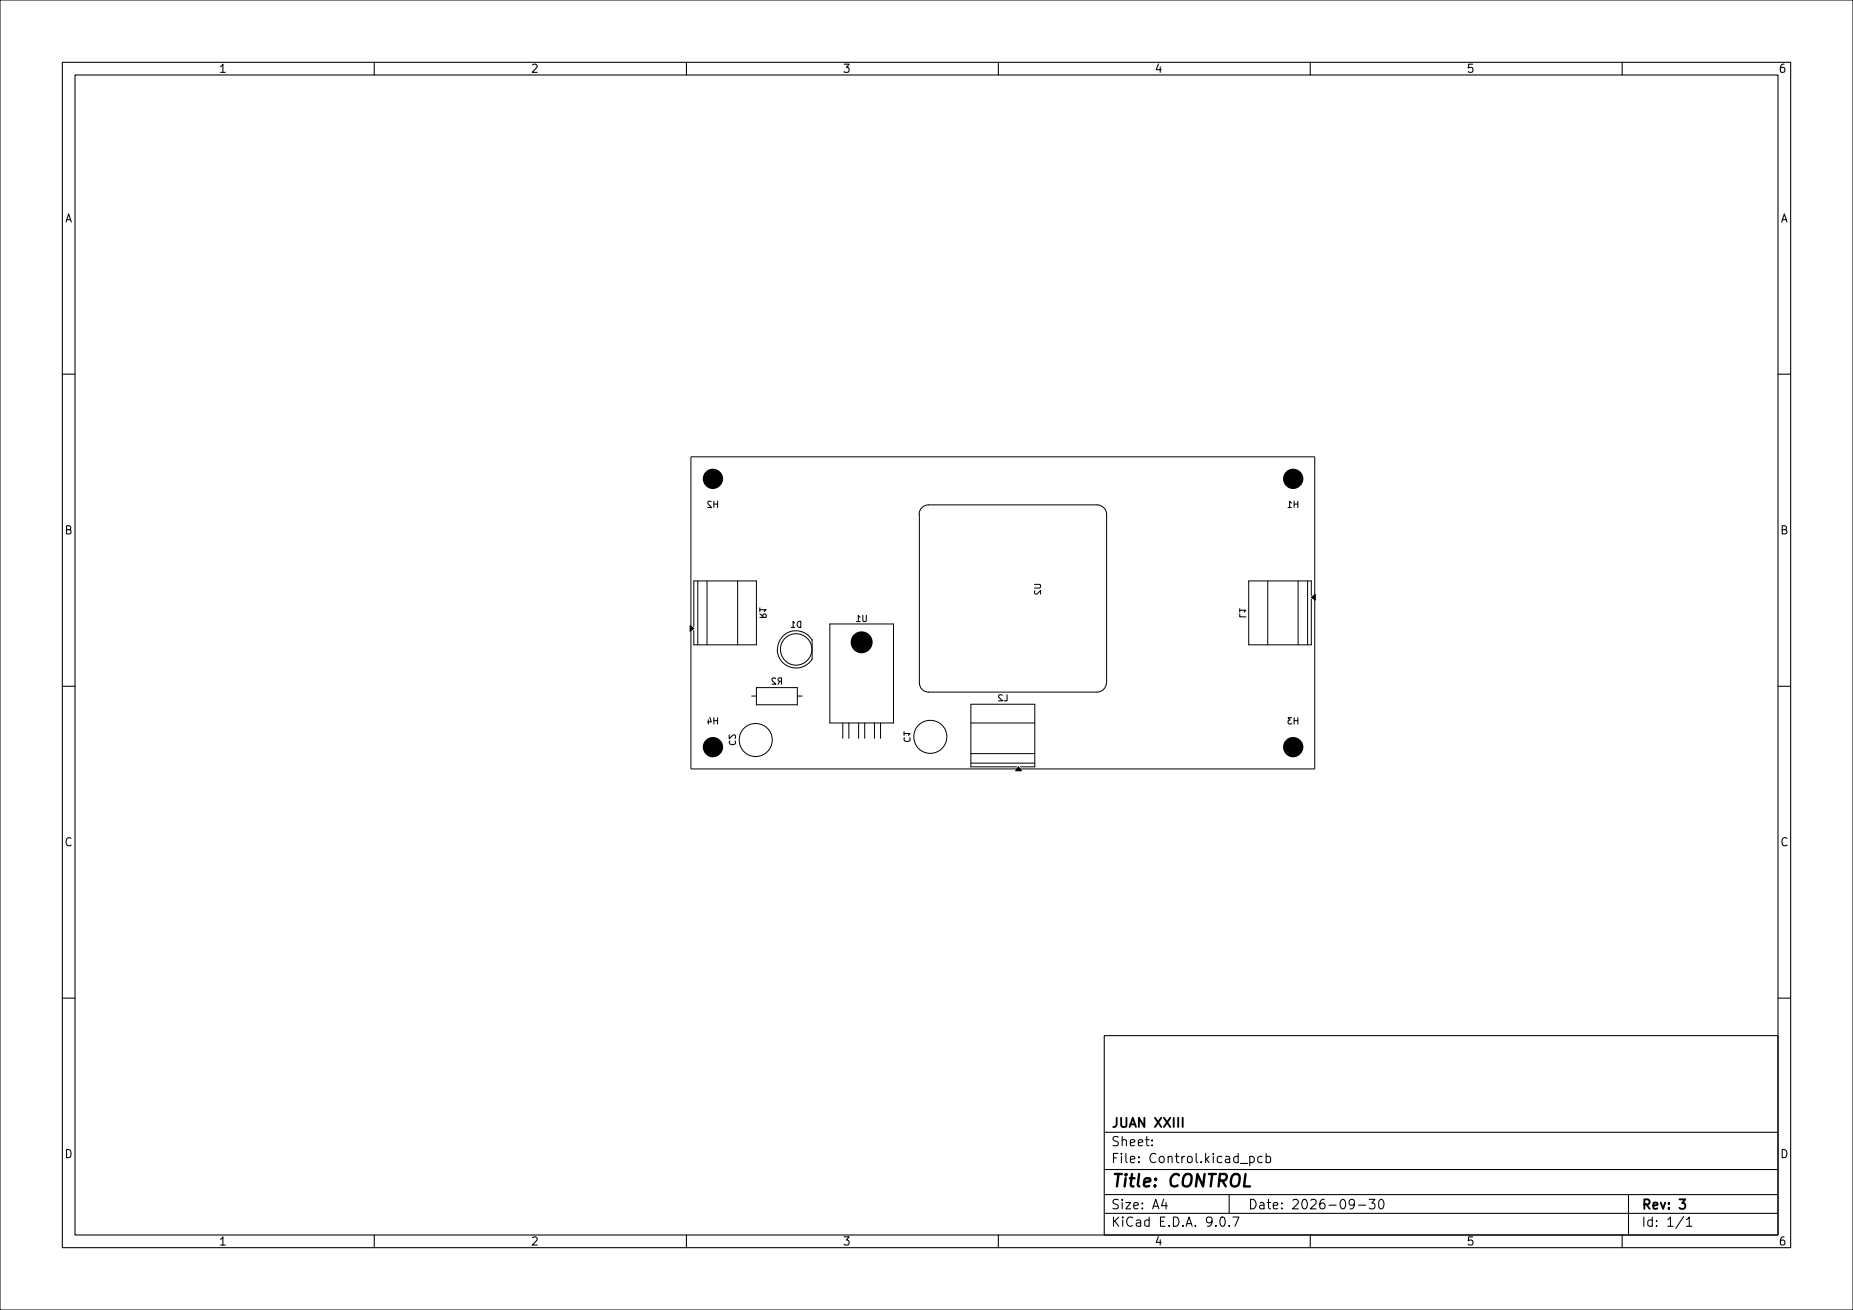
[picture p45: page 1]
