VittorioCoseglia/JBR/docs/PDF/Transferencia/Fuente/FuenteBc.pdf

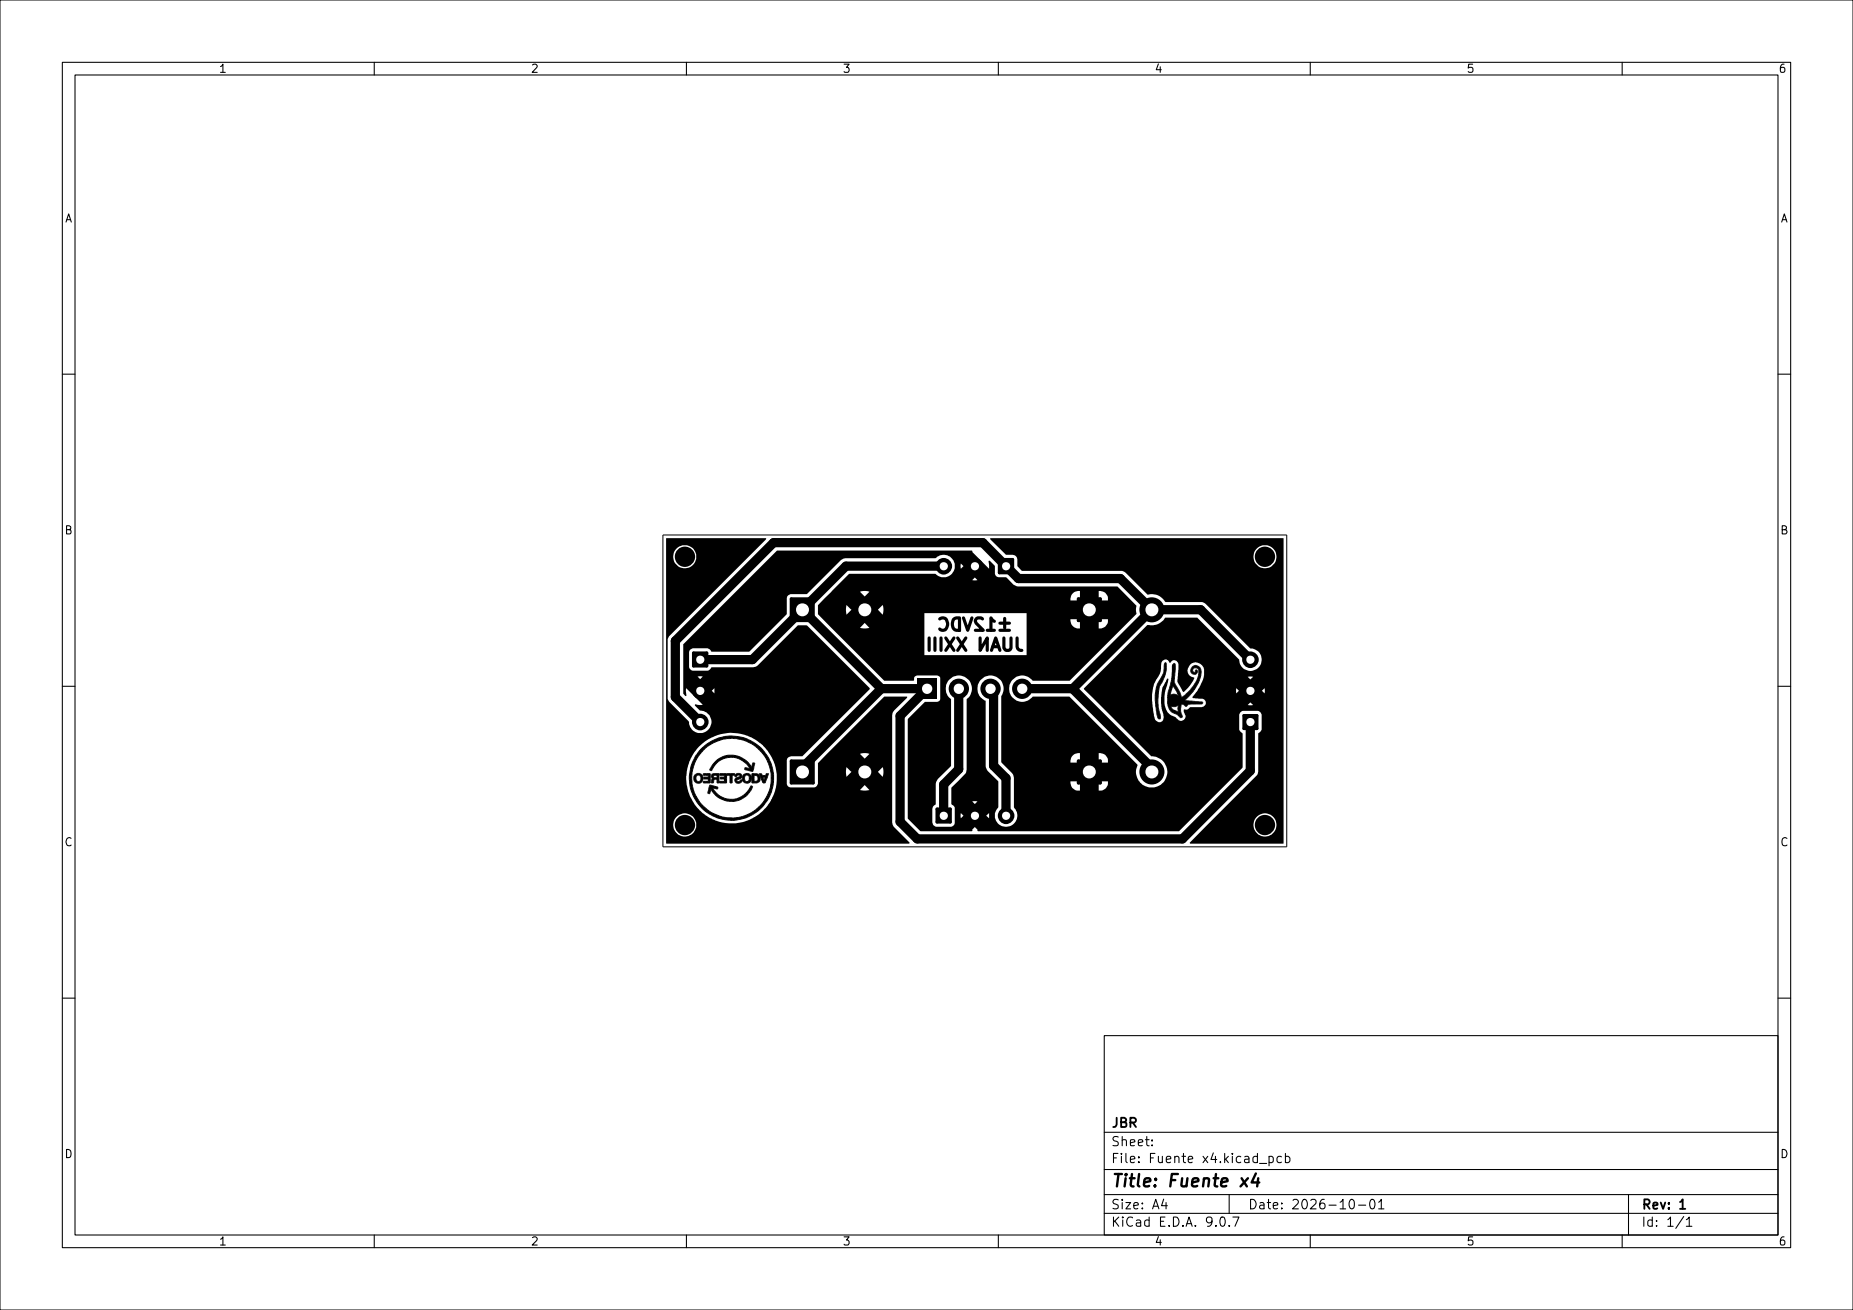
[picture p46: page 1]
