VittorioCoseglia/JBR/docs/PDF/Transferencia/Fuente/FuenteSilk.pdf

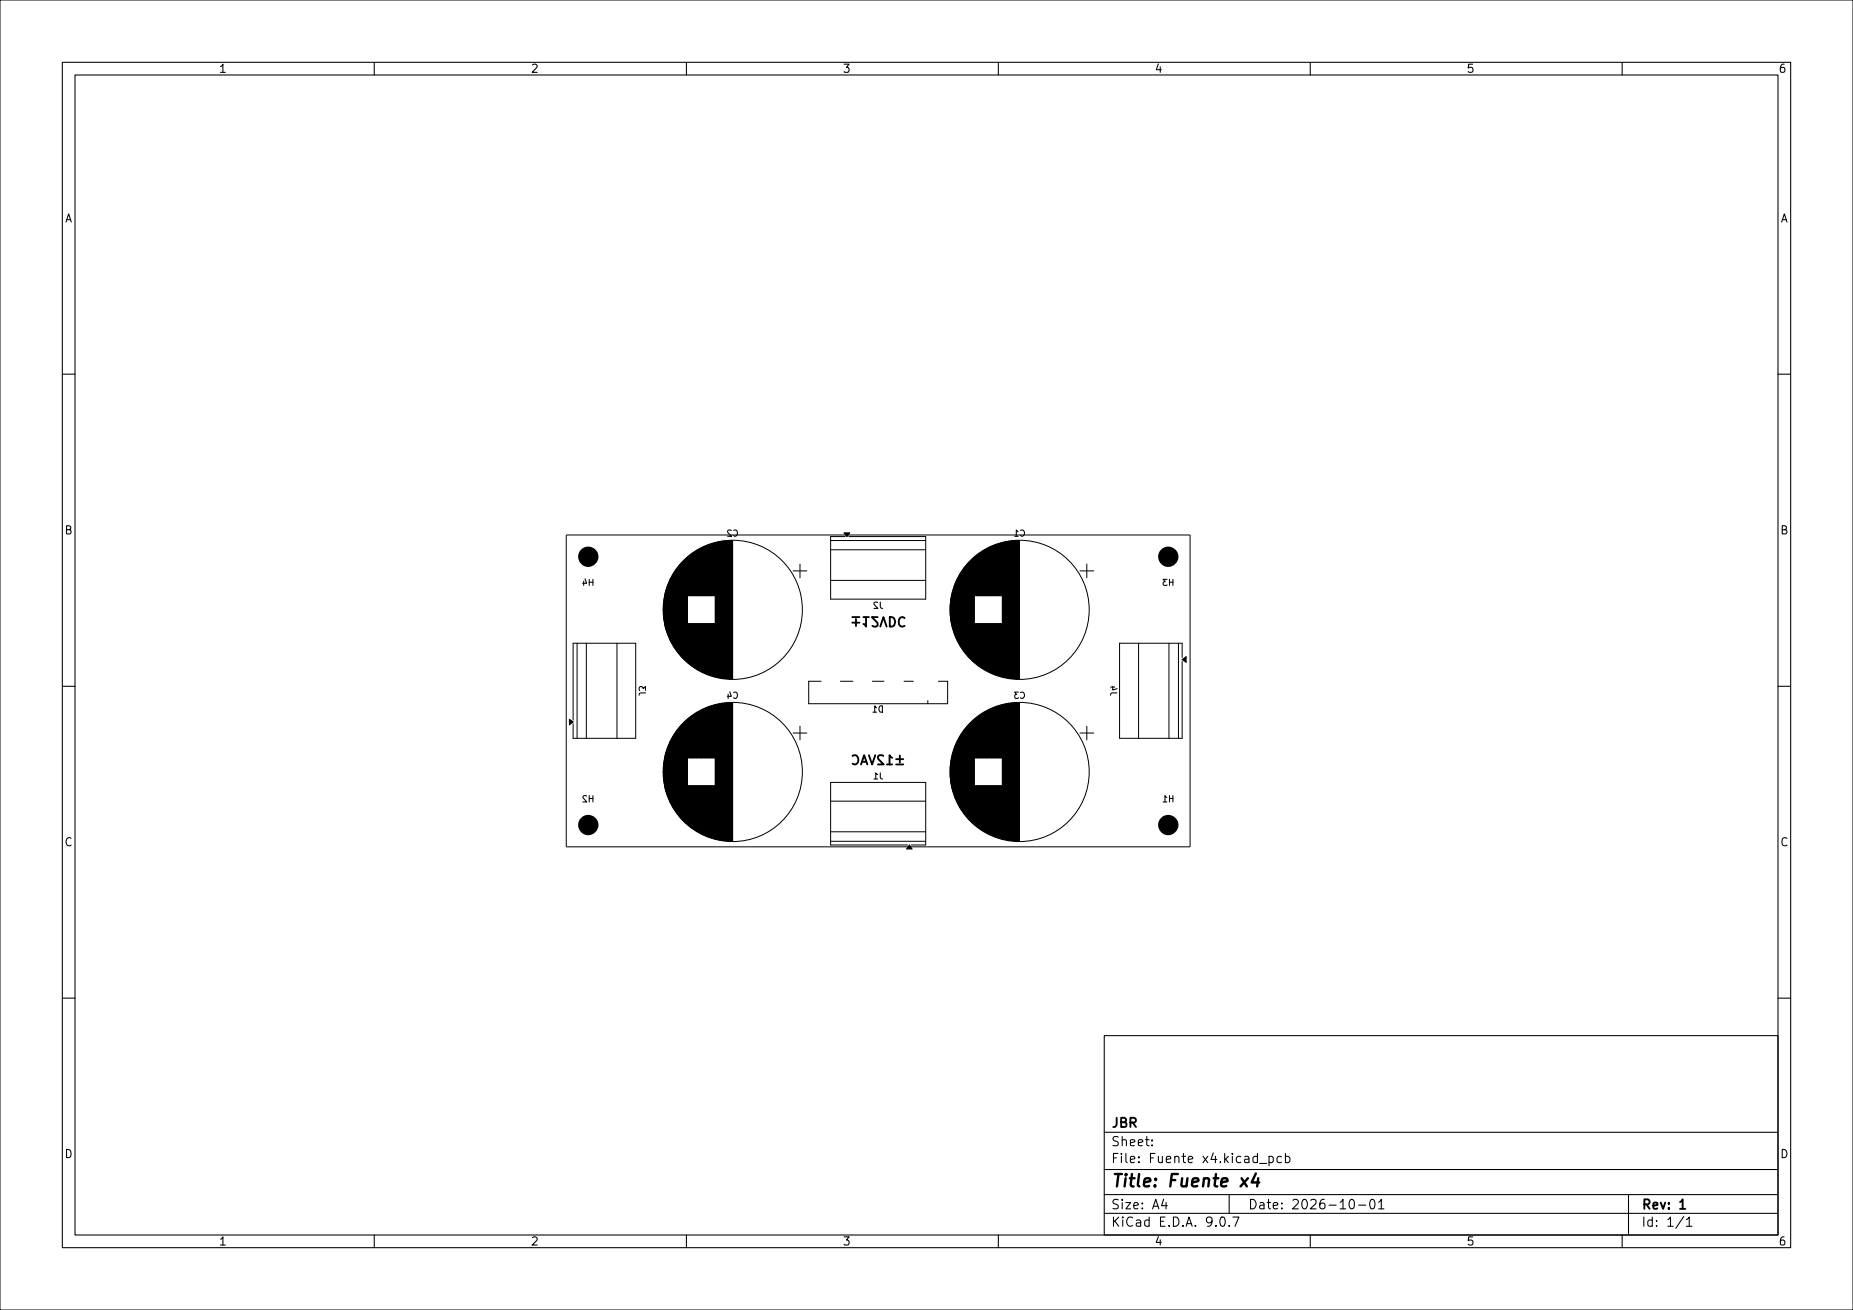
[picture p47: page 1]
