VittorioCoseglia/JBR/(list of files, drawings)

Other design files:
Simulacion/Simulation.ms14
