VittorioCoseglia/JBR/AB/AB.kicad_pcb

## KiCad design AB/AB.kicad_pcb (2026-11-05)

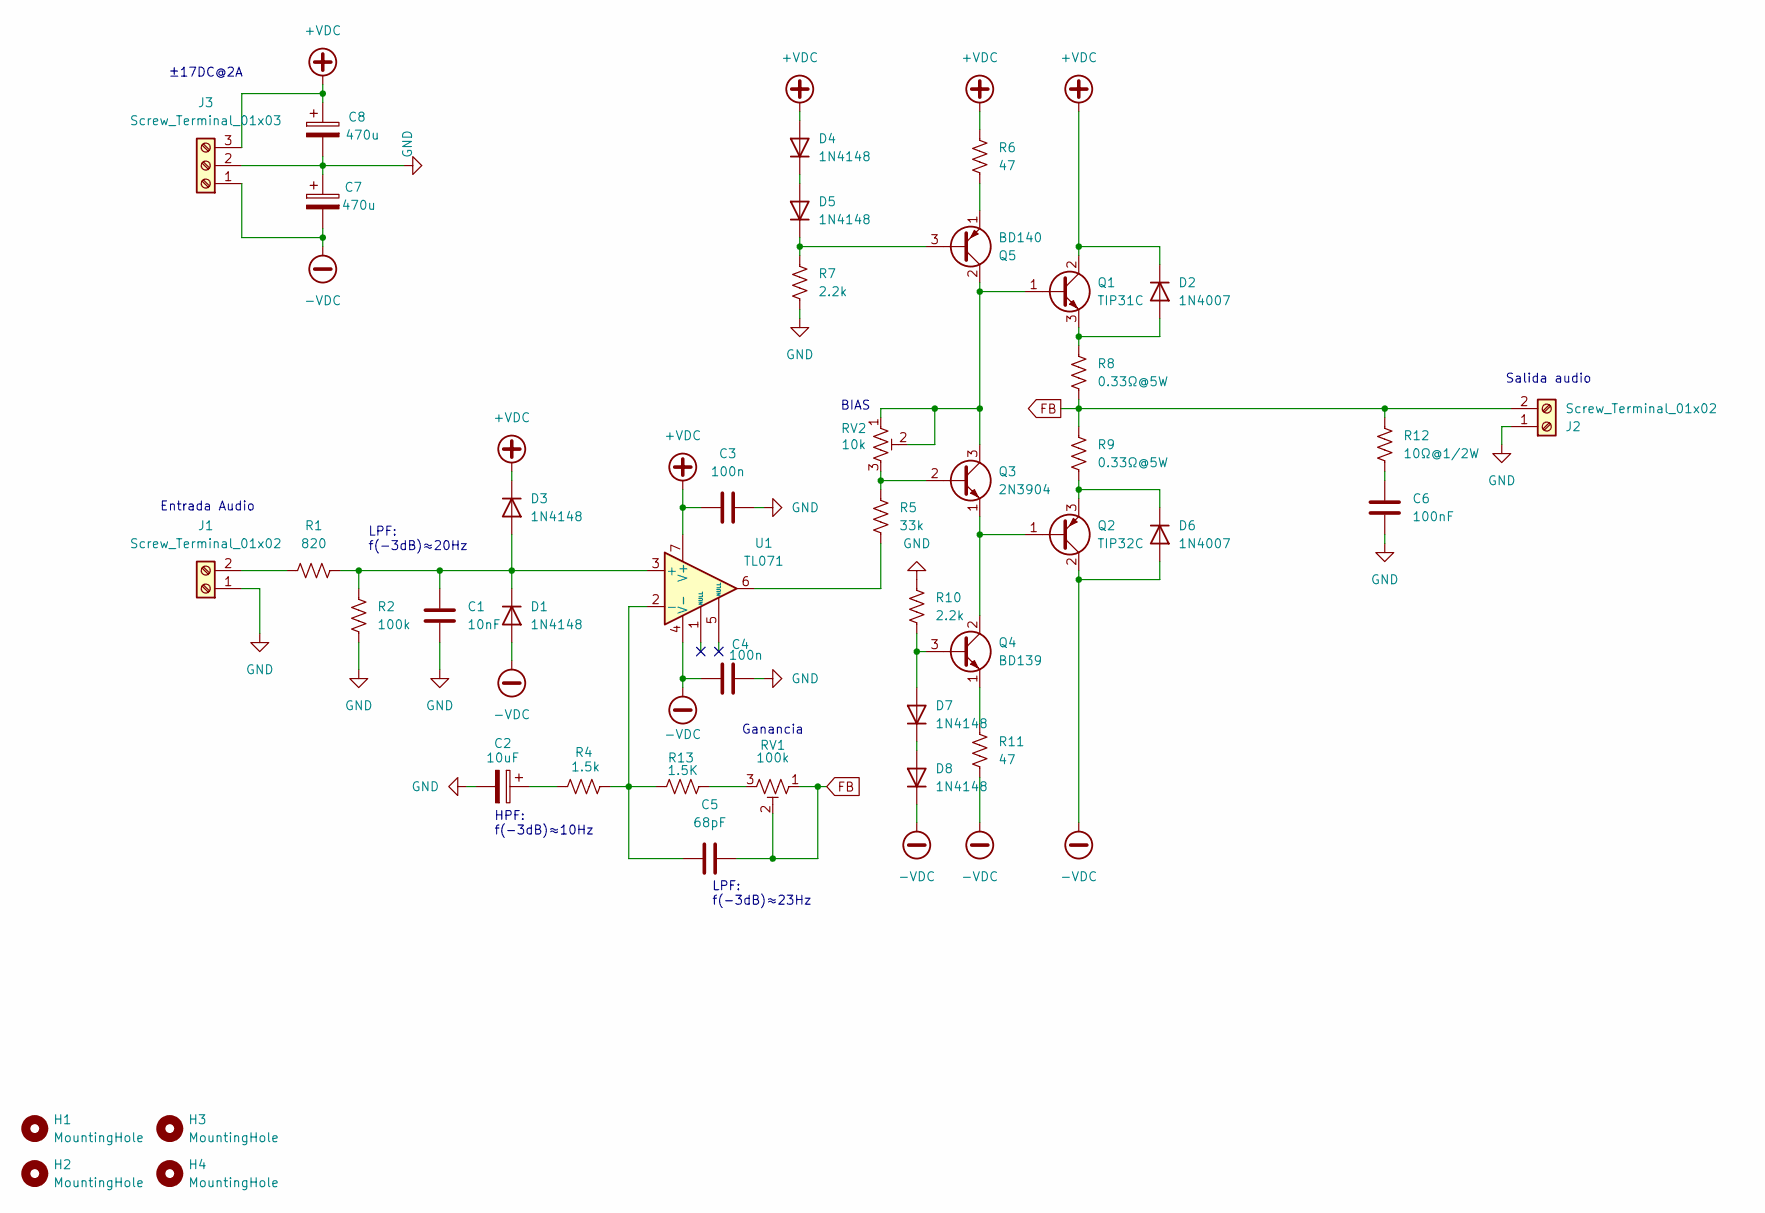
[picture p48: schematic AB.kicad_sch, AMPLIFICADOR AB 12W 8Ω]

Parts:
C1: 10nF; C_Disc_D5.0mm_W2.5mm_P2.50mm
C2: 10uF; C_Radial_D6.3mm_H11.0mm_P2.50mm
C3, C4: 100n; C_Disc_D5.0mm_W2.5mm_P2.50mm
C5: 68pF; C_Disc_D3.0mm_W2.0mm_P2.50mm
C6: 100nF; C_Disc_D5.0mm_W2.5mm_P2.50mm
C7, C8: 470u; C_Radial_D10.0mm_H20.0mm_P5.00mm
D1, D3, D4, D5, D7, D8: 1N4148; D_DO-35_SOD27_P7.62mm_Horizontal
D2, D6: 1N4007; D_DO-41_SOD81_P10.16mm_Horizontal
H1, H2, H3, H4: MountingHole; MountingHole_3.2mm_M3
J1, J2: Screw_Terminal_01x02; TerminalBlock_Phoenix_MKDS-1,5-2_1x02_P5.00mm_Horizontal
J3: Screw_Terminal_01x03; TerminalBlock_Phoenix_MKDS-1,5-3_1x03_P5.00mm_Horizontal
Q1: TIP31C; TO-220-3_Vertical
Q2: TIP32C; TO-220-3_Vertical
Q3: 2N3904; TO-92_Inline
Q4: BD139; TO-126-3_Vertical
Q5: BD140; TO-126-3_Vertical
R1: 820; R_Axial_DIN0207_L6.3mm_D2.5mm_P10.16mm_Horizontal
R2: 100k; R_Axial_DIN0207_L6.3mm_D2.5mm_P10.16mm_Horizontal
R4: 1.5k; R_Axial_DIN0207_L6.3mm_D2.5mm_P10.16mm_Horizontal
R5: 33k; R_Axial_DIN0207_L6.3mm_D2.5mm_P10.16mm_Horizontal
R6, R11: 47; R_Axial_DIN0207_L6.3mm_D2.5mm_P10.16mm_Horizontal
R7, R10: 2.2k; R_Axial_DIN0207_L6.3mm_D2.5mm_P10.16mm_Horizontal
R8, R9: 0.33Ω@5W; R_Axial_Power_L25.0mm_W6.4mm_P30.48mm
R12: 10Ω@1/2W; R_Axial_DIN0309_L9.0mm_D3.2mm_P15.24mm_Horizontal
R13: 1.5K; R_Axial_DIN0207_L6.3mm_D2.5mm_P10.16mm_Horizontal
RV1: 100k; Potentiometer_Bourns_3296W_Vertical
RV2: 10k; Potentiometer_Bourns_3296W_Vertical
U1: TL071; DIP-8_W7.62mm

Connections:
+VDC: C3.2, C8.1, D2.1 (K), D3.1 (K), D4.2 (A), J3.3, Q1.2 (C), R6.1, U1.7 (V+)
-VDC: C4.2, C7.2, D1.2 (A), D6.2 (A), D8.1 (K), J3.1, Q2.2 (C), R11.2, U1.4 (V-)
FB: C5.1, J2.2, R8.2, R9.1, R12.1, RV1.1, RV1.2
GND: C1.2, C2.2, C3.1, C4.1, C6.2, C7.1, C8.2, J1.1, J2.1, J3.2, R2.2, R7.2, R10.1
unnamed: C2.1, R4.1
unnamed: C6.1, R12.2
unnamed: C1.1, D1.1 (K), D3.2 (A), R1.2, R2.1, U1.3 (+)
unnamed: D2.2 (A), Q1.3 (E), R8.1
unnamed: D4.1 (K), D5.2 (A)
unnamed: D5.1 (K), Q5.3 (B), R7.1
unnamed: D6.1 (K), Q2.3 (E), R9.2
unnamed: D7.2 (A), Q4.3 (B), R10.2
unnamed: D7.1 (K), D8.2 (A)
unnamed: J1.2, R1.1
unnamed: Q1.1 (B), Q3.3 (C), Q5.2 (C), RV2.1, RV2.2
unnamed: Q2.1 (B), Q3.1 (E), Q4.2 (C)
unnamed: Q3.2 (B), R5.1, RV2.3
unnamed: Q4.1 (E), R11.1
unnamed: Q5.1 (E), R6.2
unnamed: R5.2, U1.6
unnamed: R13.2, RV1.3
unnamed: C5.2, R4.2, R13.1, U1.2 (-)

Notes on the sheet:
LPF: f(-3dB)≈23Hz
Ganancia
Entrada Audio
±17DC@2A
LPF: f(-3dB)≈20Hz
BIAS
HPF: f(-3dB)≈10Hz
Salida audio

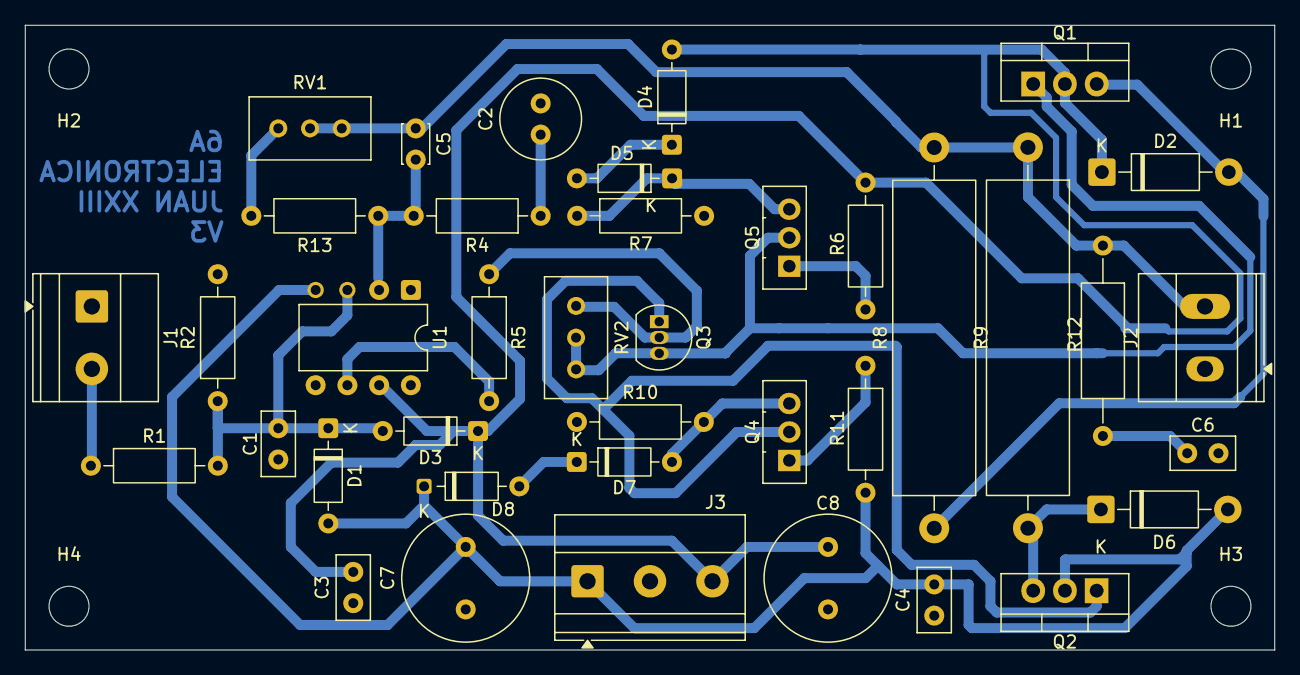
[picture p49: board AB.kicad_pcb from above]

Board: 2 copper layers, 100.0 x 50.0 mm, 43 parts (0 on the bottom side), 22 nets.
