VittorioCoseglia/JBR/Control/Control.kicad_pcb

## KiCad design Control/Control.kicad_pcb (2026-11-05)

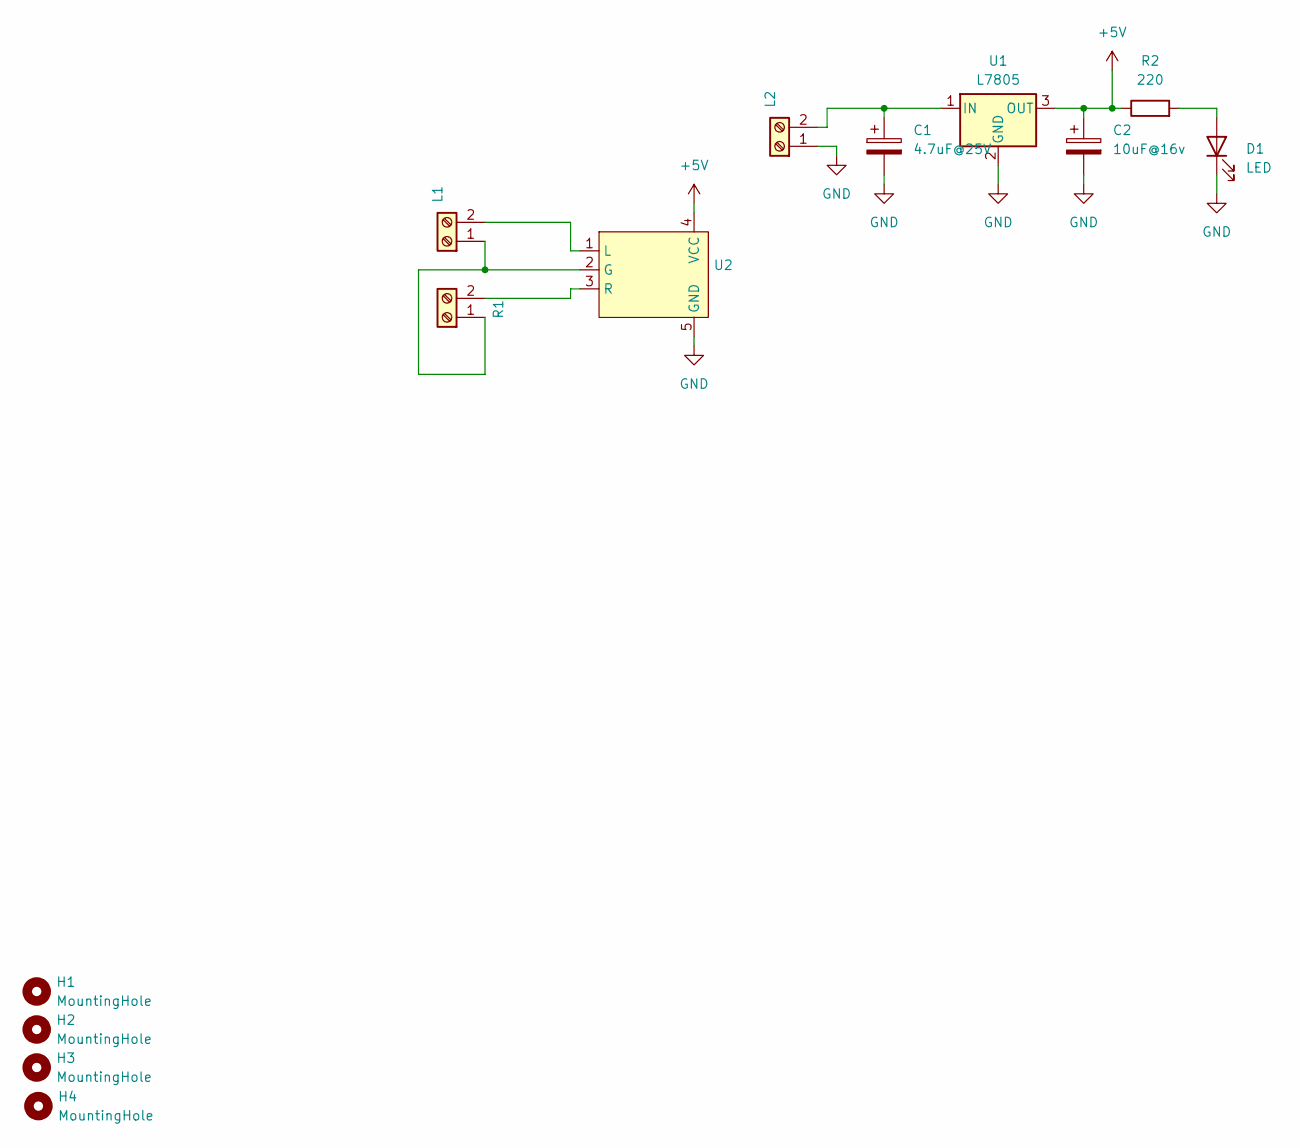
[picture p50: schematic Control.kicad_sch]

Parts:
C1: 4.7uF@25V; C_Radial_D5.0mm_H11.0mm_P2.00mm
C2: 10uF@16v; C_Radial_D5.0mm_H11.0mm_P2.00mm
D1: LED; LED_D5.0mm
H1, H2, H3, H4: MountingHole; MountingHole_3.2mm_M3
L1, L2: Screw_Terminal_01x02; TerminalBlock_Phoenix_MKDS-1,5-2_1x02_P5.00mm_Horizontal
R1: Screw_Terminal_01x02; TerminalBlock_Phoenix_MKDS-1,5-2_1x02_P5.00mm_Horizontal
R2: 220; R_Axial_DIN0207_L6.3mm_D2.5mm_P10.16mm_Horizontal
U1: L7805; TO-220-3_Horizontal_TabDown
U2: VHM-314

Connections:
+5V: C2.1, R2.1, U1.3 (OUT), U2.4 (VCC)
GND: C1.2, C2.2, D1.1 (K), L2.1, U1.2 (GND), U2.5 (GND)
unnamed: D1.2 (A), R2.2
unnamed: L1.1, R1.1, U2.2 (G)
unnamed: L1.2, U2.1 (L)
unnamed: C1.1, L2.2, U1.1 (IN)
unnamed: R1.2, U2.3 (R)

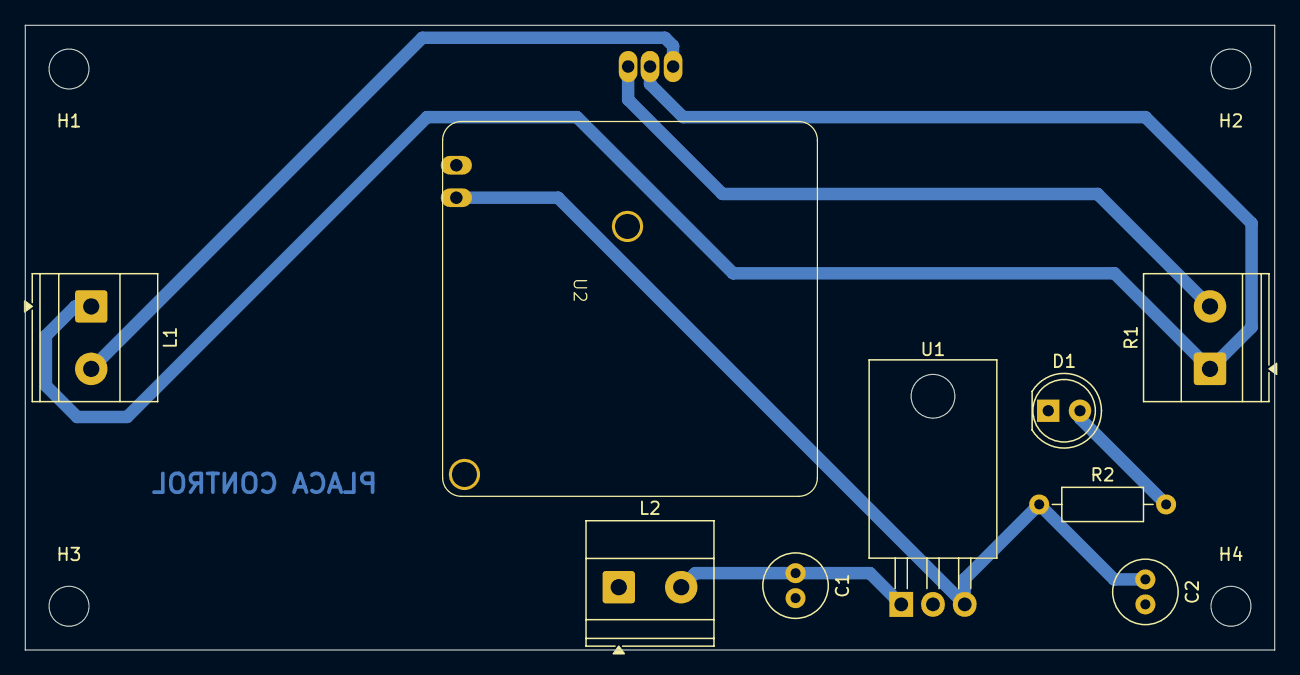
[picture p51: board Control.kicad_pcb from above]

Board: 2 copper layers, 100.0 x 50.0 mm, 13 parts (0 on the bottom side), 7 nets.
