VittorioCoseglia/JBR/Fuente/Fuente x4.kicad_pcb

## KiCad design Fuente/Fuente x4.kicad_pcb (2026-10-29)

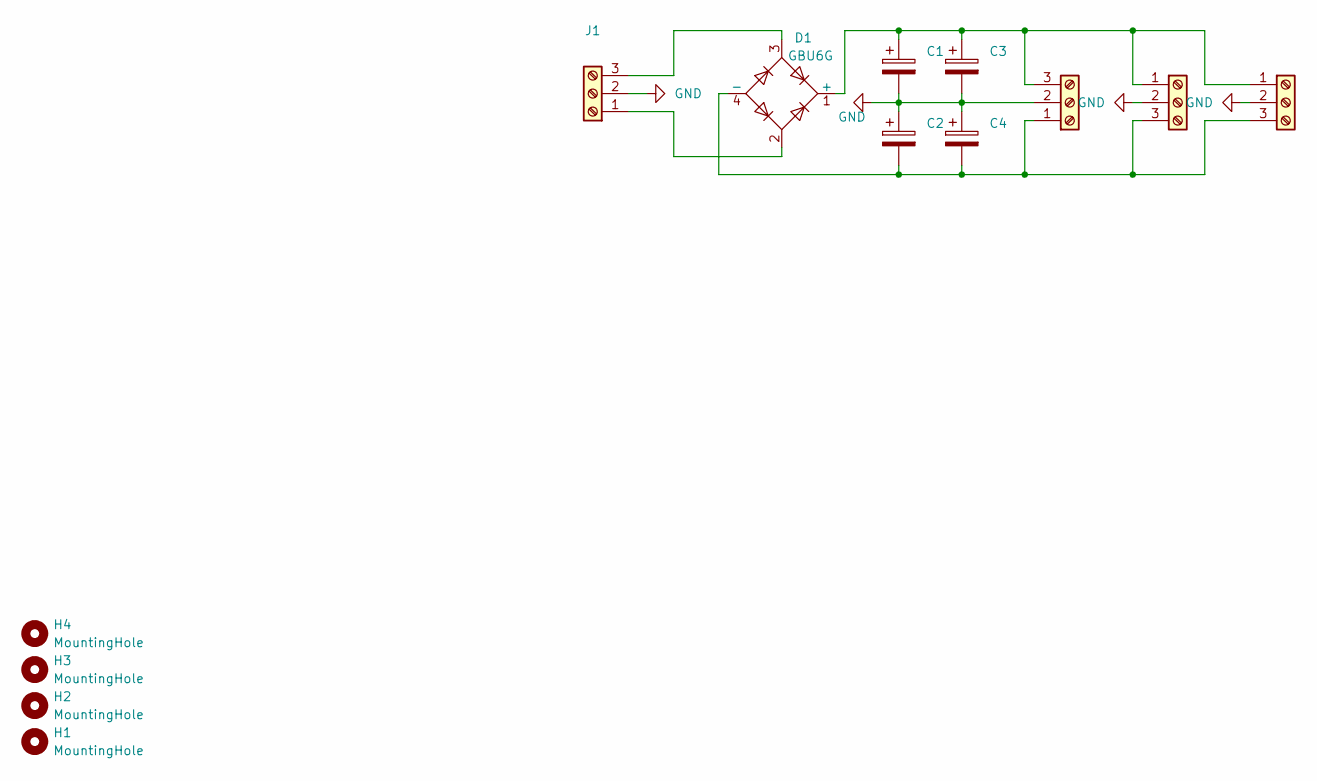
[picture p52: schematic Fuente x4.kicad_sch, Fuente x4 C]

Parts:
C1, C2, C3, C4: C_Polarized; CP_Radial_D22.0mm_P10.00mm_SnapIn
D1: GBU6G; Diode_Bridge_Vishay_GBU
H1, H2, H3, H4: MountingHole; MountingHole_3.2mm_M3
J1, J2, J3, J4: Screw_Terminal_01x03; TerminalBlock_Phoenix_MKDS-1,5-3_1x03_P5.00mm_Horizontal

Connections:
GND: C1.2, C2.1, C3.2, C4.1, J1.2, J2.2, J3.2, J4.2
unnamed: C1.1, C3.1, D1.1 (+), J2.3, J3.1, J4.1
unnamed: C2.2, C4.2, D1.4 (-), J2.1, J3.3, J4.3
unnamed: D1.2, J1.1
unnamed: D1.3, J1.3

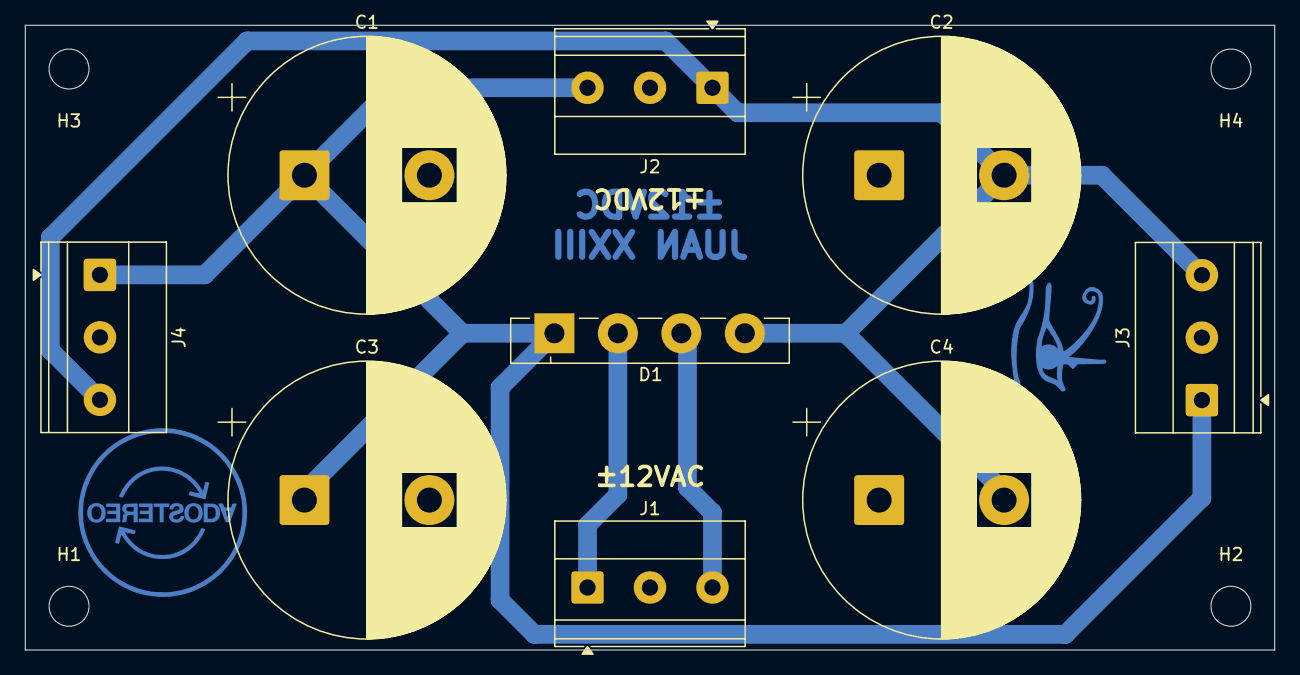
[picture p53: board Fuente x4.kicad_pcb from above]

Board: 2 copper layers, 100.0 x 50.0 mm, 13 parts (0 on the bottom side), 5 nets.
