VittorioCoseglia/JBR/(commit log)

2026-11-03 Hoja de datos
2026-11-03 Simulacion MS14
    [Simulation.ms14]
2026-11-05 Bill of materials
    [BOM.xlsx]
